acevedocrisologopablo48-lgtm/simulacion-bigbag-sesuveca/README.md

# Estación de descarga de BigBags

SESUVECA DEL PERÚ.

BigBag de 1 t. Descarga por manga y ensacado manual de 25 o 50 kg.

- [Planos](assets/docs/Planos_estacion_bigbag.pdf)
- [Materiales](assets/docs/Lista_materiales.pdf)
- [Materiales Excel](assets/docs/Lista_materiales.xlsx)
- [Archivos de taller](assets/docs/Documentacion_estacion_bigbag.zip)
- [Modelo 3D](assets/docs/Modelo_estacion_bigbag.zip)
