acevedocrisologopablo48-lgtm/simulacion-bigbag-sesuveca/assets/docs/Lista_materiales.pdf

TÍTULO

## Lista de materiales

DIBUJÓ: Javier Acevedo | FECHA: 10/11/2026 | HOJA 1 DE 3

# Estación de descarga de BigBags

## Perfiles y barras

### Peso neto de acero: 5.259,5 kg Compra estimada: 8.146,0 kg

MATERIAL | CONSUMO | PESO NETO kg | COMPRA | ESPECIFICACIÓN | PESO COMPRA kg
Tubo Ø42,4 x 2,9 mm | 17,78 m | 50,3 | 4 barras de 6 m | Tubo comercial ISO65 OD42,4x2,9 mm | 67,8
Tubo Ø48,3 x 2,9 mm | 31,29 m | 102,4 | 6 barras de 6 m | Tubo comercial ISO65 OD48,3x2,9 mm | 116,9
Tubo Ø60,3 x 3,91 mm | 34,72 m | 191,6 | 7 barras de 6 m | ASTM A53 Gr.B SCH40; OD60,3x3,91 mm | 228,4
HEB200 | 3,60 m | 220,2 | 1 barra de 6 m | HE200B / HEB200 S355; 200x200x9x15, r18; 61,3 kg/m | 367,8
IPE200 | 4,00 m | 85,6 | 1 barra de 6 m | IPE200 ASTM A36; cierre A36 de 8 mm en planchas | 134,4
Macizo 40x60 mm | 0,120 m | 2,3 | 0,17 m en cortes / retazos | ASTM A36 | 3,2
Macizo 60x60 mm | 2,34 m | 66,1 | 1 barra de 6 m | ASTM A36 | 169,6
RHS 100x60x6.3 | 7,25 m | 97,7 | 2 barras de 6 m | S355NH / EN10210-1 | 175,0
RHS 150x75x5 | 22,49 m | 371,6 | 5 barras de 6 m | ASTM A500 Gr.B | 506,3
RHS 60x40x4 | 0,515 m | 3,0 | 0,6 m en cortes / retazos | ASTM A500 Gr.B | 3,5
Redondo Ø16 mm | 0,300 m | 0,4 | 0,36 m en cortes / retazos | ASTM A36 | 0,6
Redondo Ø20 mm | 0,695 m | 1,6 | 0,8 m en cortes / retazos | ASTM A36; eje mecanizado 20h9 y puño | 2,0
Redondo Ø40 mm | 0,285 m | 1,4 | 0,35 m en cortes / retazos | ASTM A36; mecanizar aOD36/ID22 | 3,5
SHS 100x100x5 | 35,70 m | 525,5 | 7 barras de 6 m | ASTM A500 Gr.B | 626,4
SHS 150x150x6 | 37,66 m | 1.005,1 | 4 barras de 12 m | ASTM A500 Gr.B | 1.302,2
SHS 40x40x3 | 1,73 m | 6,0 | 1 barra de 6 m | ASTM A500 Gr.B | 20,9
SHS 50x50x4 | 0,135 m | 0,8 | 0,18 m en cortes / retazos | ASTM A500 Gr.B | 1,0
SHS 60x60x4 | 76,79 m | 527,5 | 7 barras de 6 m + 4 barras de 12 m | ASTM A500 Gr.B | 633,0

Cantidades de compra con reserva mínima de corte del 10% y redondeo a formatos comerciales.

TÍTULO

# Estación de descarga de BigBags

## Planchas y otros materiales

### Peso neto de acero: 5.259,5 kg Compra estimada: 8.146,0 kg

MATERIAL | CONSUMO | PESO NETO kg | COMPRA | PESO COMPRA kg
Plancha A36 de 3 mm | 4,50 m² brutos | 100,8 | 1 plancha de 2x6 m | 282,6
Plancha A36 de 5 mm | 0,016 m² brutos | 0,6 | 0,018 m² en cortes de 5 mm | 0,7
Plancha A36 de 6 mm | 5,61 m² brutos | 239,7 | 2 planchas de 1,5x3 m | 423,9
Plancha A36 de 8 mm | 11,10 m² brutos | 445,9 | 5 planchas de 1,5x3 m | 1.413,0
Plancha A36 de 10 mm | 0,385 m² brutos | 27,9 | 0,424 m² en cortes de 10 mm | 33,3
Plancha A36 de 12 mm | 2,54 m² brutos | 214,3 | 1 plancha de 1,5x3 m | 423,9
Plancha A36 de 18 mm | 1,94 m² brutos | 205,2 | 2,133 m² en cortes de 18 mm | 301,4
Plancha A36 de 20 mm | 0,707 m² brutos | 107,9 | 0,778 m² en cortes de 20 mm | 122,1
Plancha A36 de 25 mm | 0,125 m² brutos | 24,1 | 0,138 m² en cortes de 25 mm | 27,1
Plancha A36 de 30 mm | 0,045 m² brutos | 10,6 | 0,05 m² en cortes de 30 mm | 11,8
Plancha A36 de 35 mm | 1,23 m² brutos | 293,0 | 1,359 m² en cortes de 35 mm | 373,4
Plancha A36 de 40 mm | 0,047 m² brutos | 9,4 | 0,052 m² en cortes de 40 mm | 16,3
Plancha A36 de 45 mm | 0,461 m² brutos | 162,4 | 0,507 m² en cortes de 45 mm | 179,1
Conjuntos de acero formado | 158,45 kg | 158,5 | 175 kg para fabricar según planos | 175,0
Peldaños 800x250 mm | 15,00 ud | - | 15 peldaños completos | -
Rejilla de piso y transición | 4,90 m² | - | 5,39 m² cortados | -
UHMWPE de 10 mm | 12,55 m² brutos | - | 13,804 m² en cortes | -
Goma de abrazadera | 1,00 juego | - | 1 juego de revestimiento | -

Planchas ASTM A36. Rejilla portante de 32 x 5 mm y PE-UHMW1000 de 10 mm. Conjuntos formados según planos.

Cantidades de compra con reserva mínima de corte del 10% y redondeo a formatos comerciales.

TÍTULO

# Estación de descarga de BigBags

## Equipos y suministros

Cantidades por estación. BigBag de trabajo de 1 t; sacos de 25 y 50 kg.

EQUIPO | CANTIDAD | ESPECIFICACIÓN TÉCNICA
Tecle y carro eléctricos | 1 conjunto | KITO SHER2M020IS-IS, capacidad 2 t; altura reducida 475 mm; masa 212 kg. Suministro 380 V, trifásico, 60 Hz. Cadena útil mínima 4 m; carro para ala de 200 x 15 mm y traslado limitado a 10 m/min. Potencia de referencia a 50 Hz: izaje 3,5 kW y carro 0,4 kW. Incluye ruedas, cadena, gancho, frenos y finales de carrera. BigBag de trabajo 1.000 kg más aparejo de 260 kg.
Balanza fija | 1 kit | Capacidad útil 150 kg; tara admisible mínima 120 kg; lectura 0,05 kg. Cuatro celdas Dini Argeo FXC200-1, C3, 200 kg/celda, 2 mV/V, IP68; indicador DFWL, caja sumadora de 4 vías, cables y montajes. Plato 900 x 1.000 mm a 350 mm del piso; masa móvil 97,13 kg. Calibración y ajuste de esquinas al montaje.
Mando y conexión del tecle | 1 juego | Mando mantenido de 4 movimientos, parada enclavable y rearme, a 1,25 m del piso. Cableado, festón y protecciones compatibles con el tecle. Incluir en el suministro del conjunto.
Filtro de venteo | 1 unidad | Conexión DN150 y cartucho antiestático para polvo de carbón; montaje y sellos incluidos. Venteo por desplazamiento de aire, sin ventilador.
Sello flexible de recepción | 1 juego | Receptor de entrada libre Ø450 mm; manga de BigBag Ø350 mm. Sello de doble labio, Ø450 x 55 mm, en elastómero disipativo compatible con carbón y limpieza.
Apoyos y retención de paleta | 1 kit | Dos bujes igus GSM-2022-20, Ø20/22 x 20 mm, y dos collares partidos Ruland MSP-20-F, Ø20/40 x 15 mm. Eje 20h9, alojamientos 22H7 y juego axial total 0,2-0,5 mm. Paleta Ø249 x 6 mm y cuello DN250 incluidos en el acero de fabricación.
Fijaciones de montaje | 1 lote | 52 espárragos M16 x 340, clase 10.9; 104 tuercas M16, clase 10. Ocho pernos M16 F3125/A325M para las sillas, con tuercas y arandelas compatibles. Tornillería M8 de tapas y abrazadera según plano. Las 104 arandelas A36 de 50 x 50 x 10 mm, Ø18, están incluidas en la plancha de 10 mm.

Pesos del acero. Equipos, fijaciones compradas, rejillas y polímeros se suministran por separado.
