acevedocrisologopablo48-lgtm/simulacion-bigbag-sesuveca/assets/docs/ESTACION_BIGBAG_P05.step

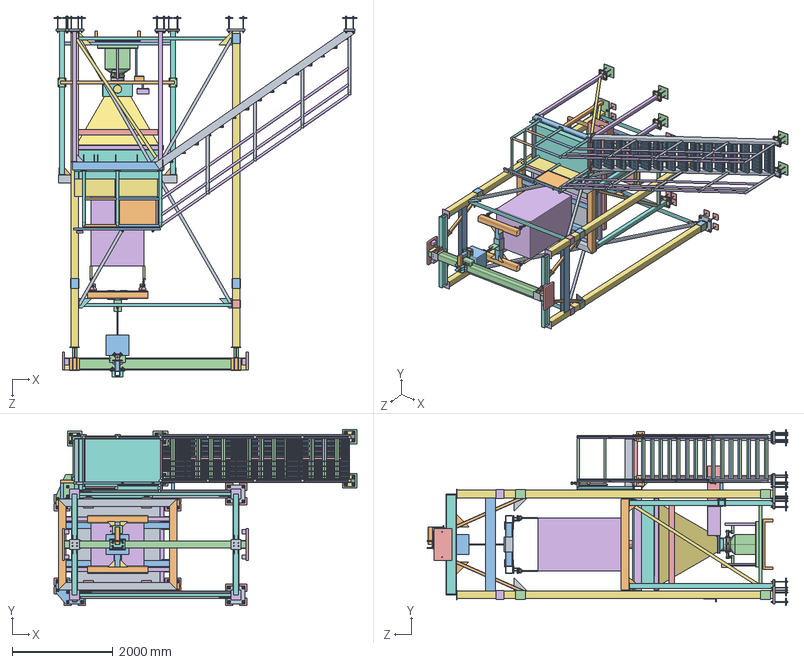
[picture p1: CAD file, 2026-10-23, last stored version]
assets/docs/ESTACION_BIGBAG_P05.step
6005.0 x 3497.5 x 7155.0 mm
BASE_PORTICO_360x360x35 x 2
BASE_TOLVA_250x250x25 x 2
BASE_COMBINADA_PORTICO_TOLVA_SUR_t35_P05
BASE_COMBINADA_PORTICO_TOLVA_NORTE_t35_P05
PASANTE_M16_8p8_L340_P05 x 52
ANCLA_ARANDELA_D30_D18_t3_REF x 28
ANCLA_TUERCA_M16_AF24_H13_REF x 28
CALCE_PASANTE_BASE_TOLVA_250x250x25_t10 x 2
CALCE_PASANTE_AC_BASE_220x220x12_t35 x 5
PASANTE_ARANDELA_A36_50x50x10_D18_P05 x 104
PASANTE_TUERCA_BRIDA_M16_CL10_D34p5_H16_REF x 104
CONTRAPLACA_COMUN_A36_290x290x18_G01_P05
CONTRAPLACA_COMUN_A36_290x290x18_G02_P05
CONTRAPLACA_COMUN_A36_290x290x18_G03_P05
CONTRAPLACA_COMUN_A36_290x290x18_G04_P05
CONTRAPLACA_COMUN_A36_290x290x18_G05_P05
CONTRAPLACA_A36_150x150x18_D18_P05 x 26
CONTRAPLACA_COMUN_A36_175x360x18_G25_P05
CONTRAPLACA_COMUN_A36_175x360x18_G30_P05
SHS150x150x6_L5488000_P05 x 4
IPE200_L2000000_P05 x 2
U01_CAP_200x200x12_P05 x 2
U01_LATERAL_200x240x12_P05 x 4
U01_CALCE_200x20x6_P05 x 8
U01_RIGIDIZADOR_44x175x6_P05 x 24
U01_CARTELA_100x240x12_P05 x 8
P01_CAP_COLUMNA_200x200x12_P05 x 4
CUNA_BOTONERA_A36_t3
SHS60x60x4_L3050000_P05_JUNTA_14
SHS60x60x4_L3050000_P05_JUNTA_15
SHS60x60x4_L6085645_SLOT_P05_JUNTA_1
SHS60x60x4_L6085645_SLOT_P05_JUNTA_2
SHS60x60x4_L748810_SLOT_P05_JUNTA_3 x 2
SHS60x60x4_L3050000_P05_JUNTA_16
SHS60x60x4_L3050000_P05_JUNTA_17
SHS60x60x4_L6085645_SLOT_P05_JUNTA_4
SHS60x60x4_L6085645_SLOT_P05_JUNTA_5
SHS60x60x4_L748810_SLOT_P05_JUNTA_6 x 2
U02_COLLAR_150x200x12_P05 x 12
U02_COLLAR_174x200x12_P05 x 12
U02_COLLAR_150x158x12_P05 x 4
U02_COLLAR_174x158x12_P05 x 4
U02_CARTELA_BRL-A--1_0_P05
U02_CARTELA_BRL-A--1_1_P05
U02_CARTELA_BRL-B--1_0_P05
U02_CARTELA_BRL-B--1_1_P05
U02_CARTELA_KNE--1_0_P05 x 2
U02_CARTELA_KNE--1_1_P05 x 2
U02_CARTELA_BRL-A-1_0_P05
U02_CARTELA_BRL-A-1_1_P05
U02_CARTELA_BRL-B-1_0_P05
U02_CARTELA_BRL-B-1_1_P05
U02_CARTELA_KNE-1_0_P05 x 2
U02_CARTELA_KNE-1_1_P05 x 2
PORTICO_CIERRE_IPE200_2000x200x8_P05 x 4
I_A240x140x8x20_L3600000_P05
TOPE_PLACA_REACCION_640x360x45_P05 x 2
TOPE_ACE_TR100_60_ENVOLVENTE_PRESELECCION_REF x 4
TOPE_RIGIDIZADOR_TERMINAL_100x240x12_P05 x 4
SHS100x100x5_L2848000_P05 x 4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
