acevedocrisologopablo48-lgtm/simulacion-bigbag-sesuveca/assets/docs/Planos_estacion_bigbag.pdf

F | F

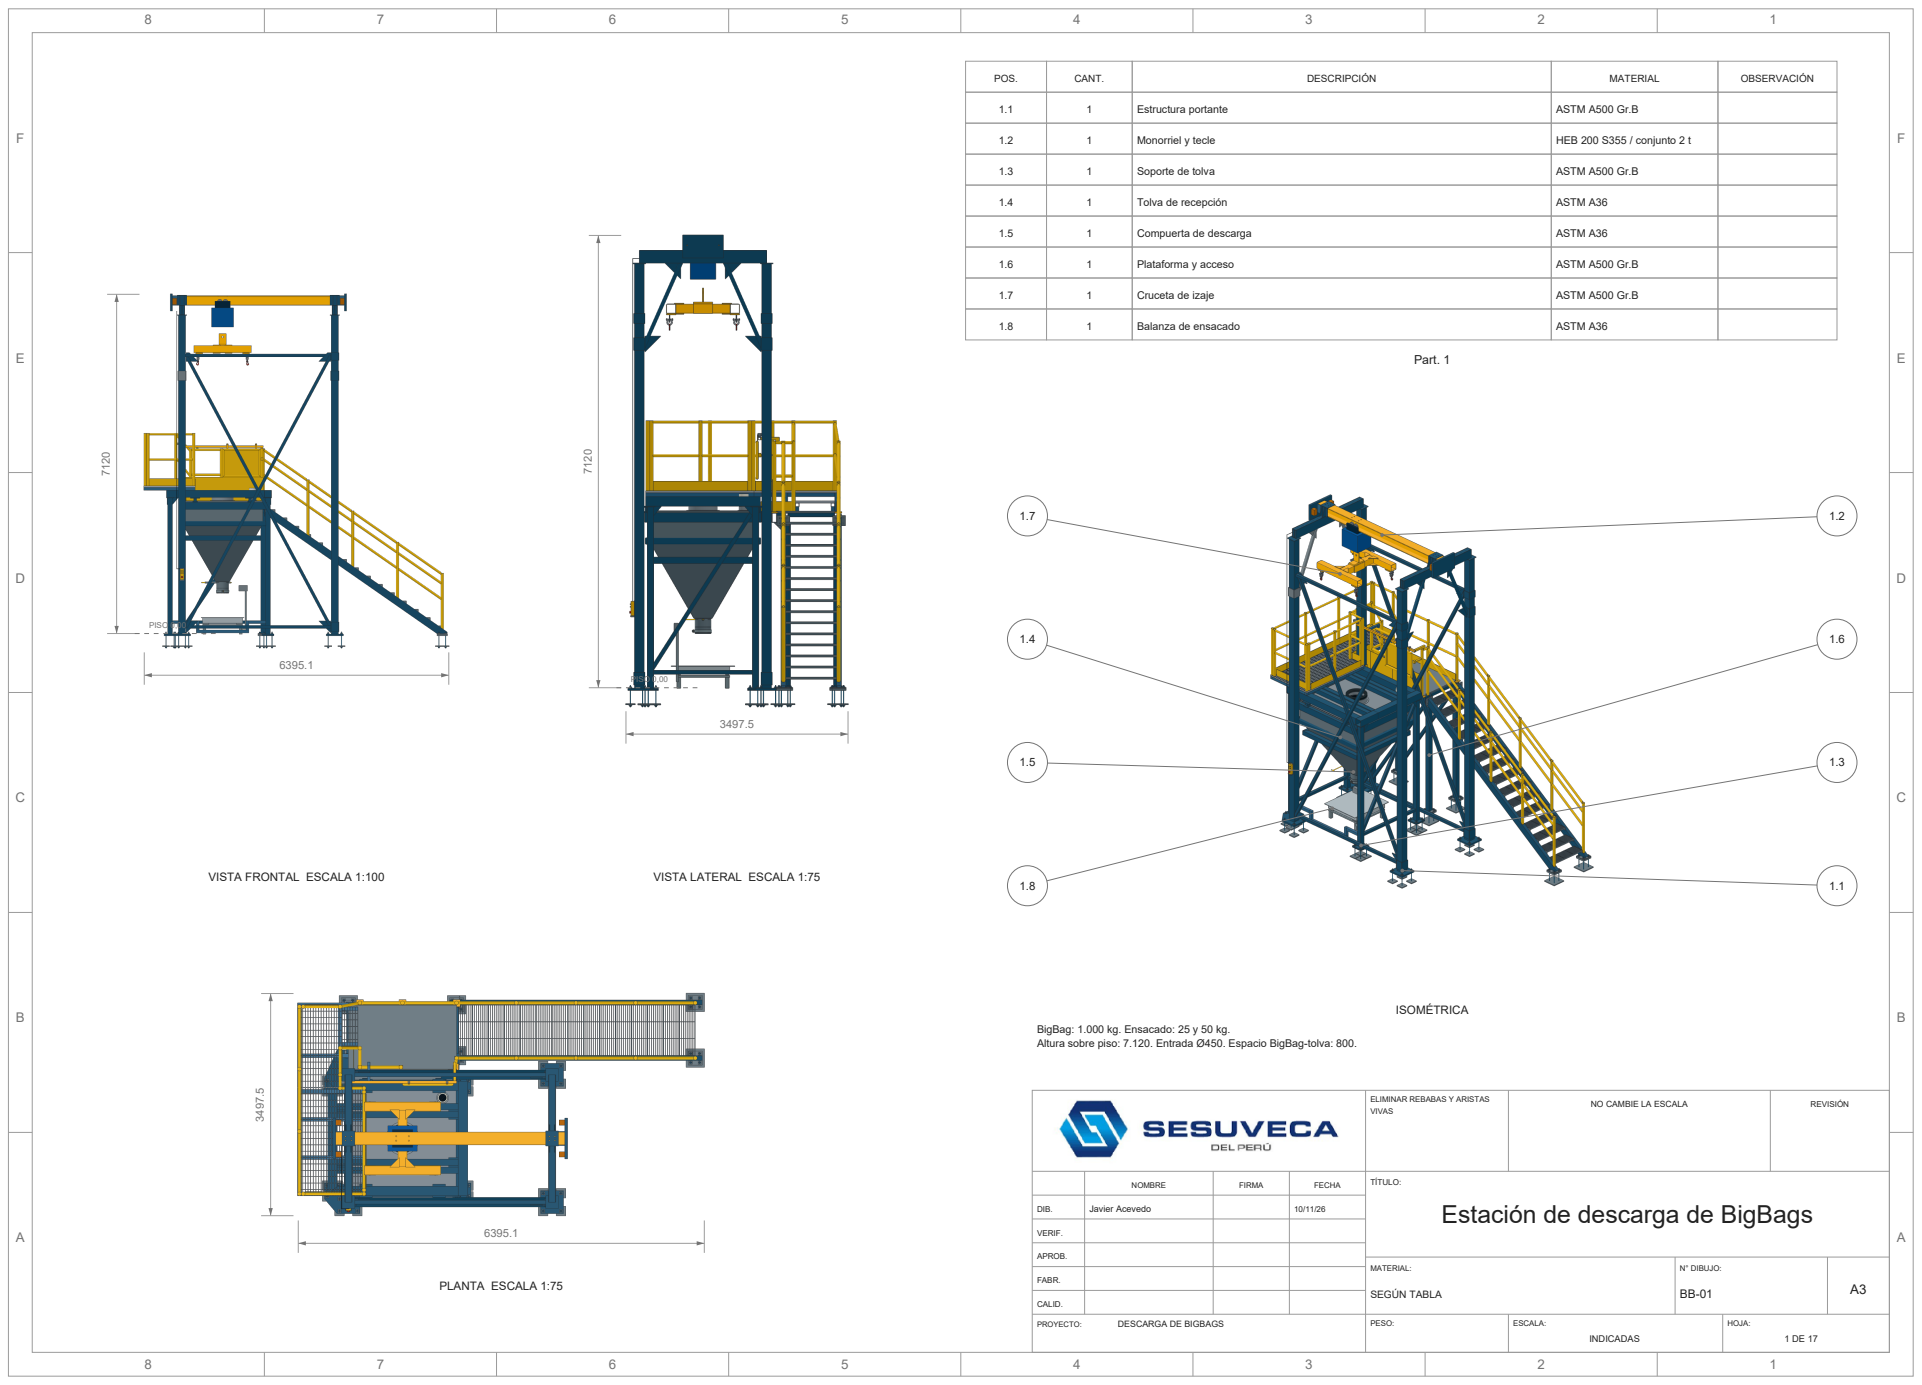
[picture p2: page 1]
NO CAMBIE LA ESCALA; REVISIÓN; NOMBRE; FIRMA; FECHA; DIB.; VERIF.; APROB.; FABR.; CALID.; Javier Acevedo; PROYECTO:; DESCARGA DE BIGBAGS; TÍTULO:; MATERIAL:; SEGÚN TABLA; N° DIBUJO:; PESO:; ESCALA:; INDICADAS; HOJA:; POS.; CANT.; DESCRIPCIÓN; MATERIAL; OBSERVACIÓN; Estructura portante; ASTM A500 Gr.B; Monorriel y tecle; HEB 200 S355 / conjunto 2 t; Soporte de tolva; Tolva de recepción; ASTM A36; Compuerta de descarga; Plataforma y acceso; Cruceta de izaje; Balanza de ensacado; PISO 0,00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

VISTA FRONTAL ESCALA 1:100

VISTA LATERAL ESCALA 1:75

BigBag: 1.000 kg. Ensacado: 25 y 50 kg.
Altura sobre piso: 7.120. Entrada Ø450. Espacio BigBag-tolva: 800.

ELIMINAR REBABAS Y ARISTAS
VIVAS

Estación de descarga de BigBags

F | F

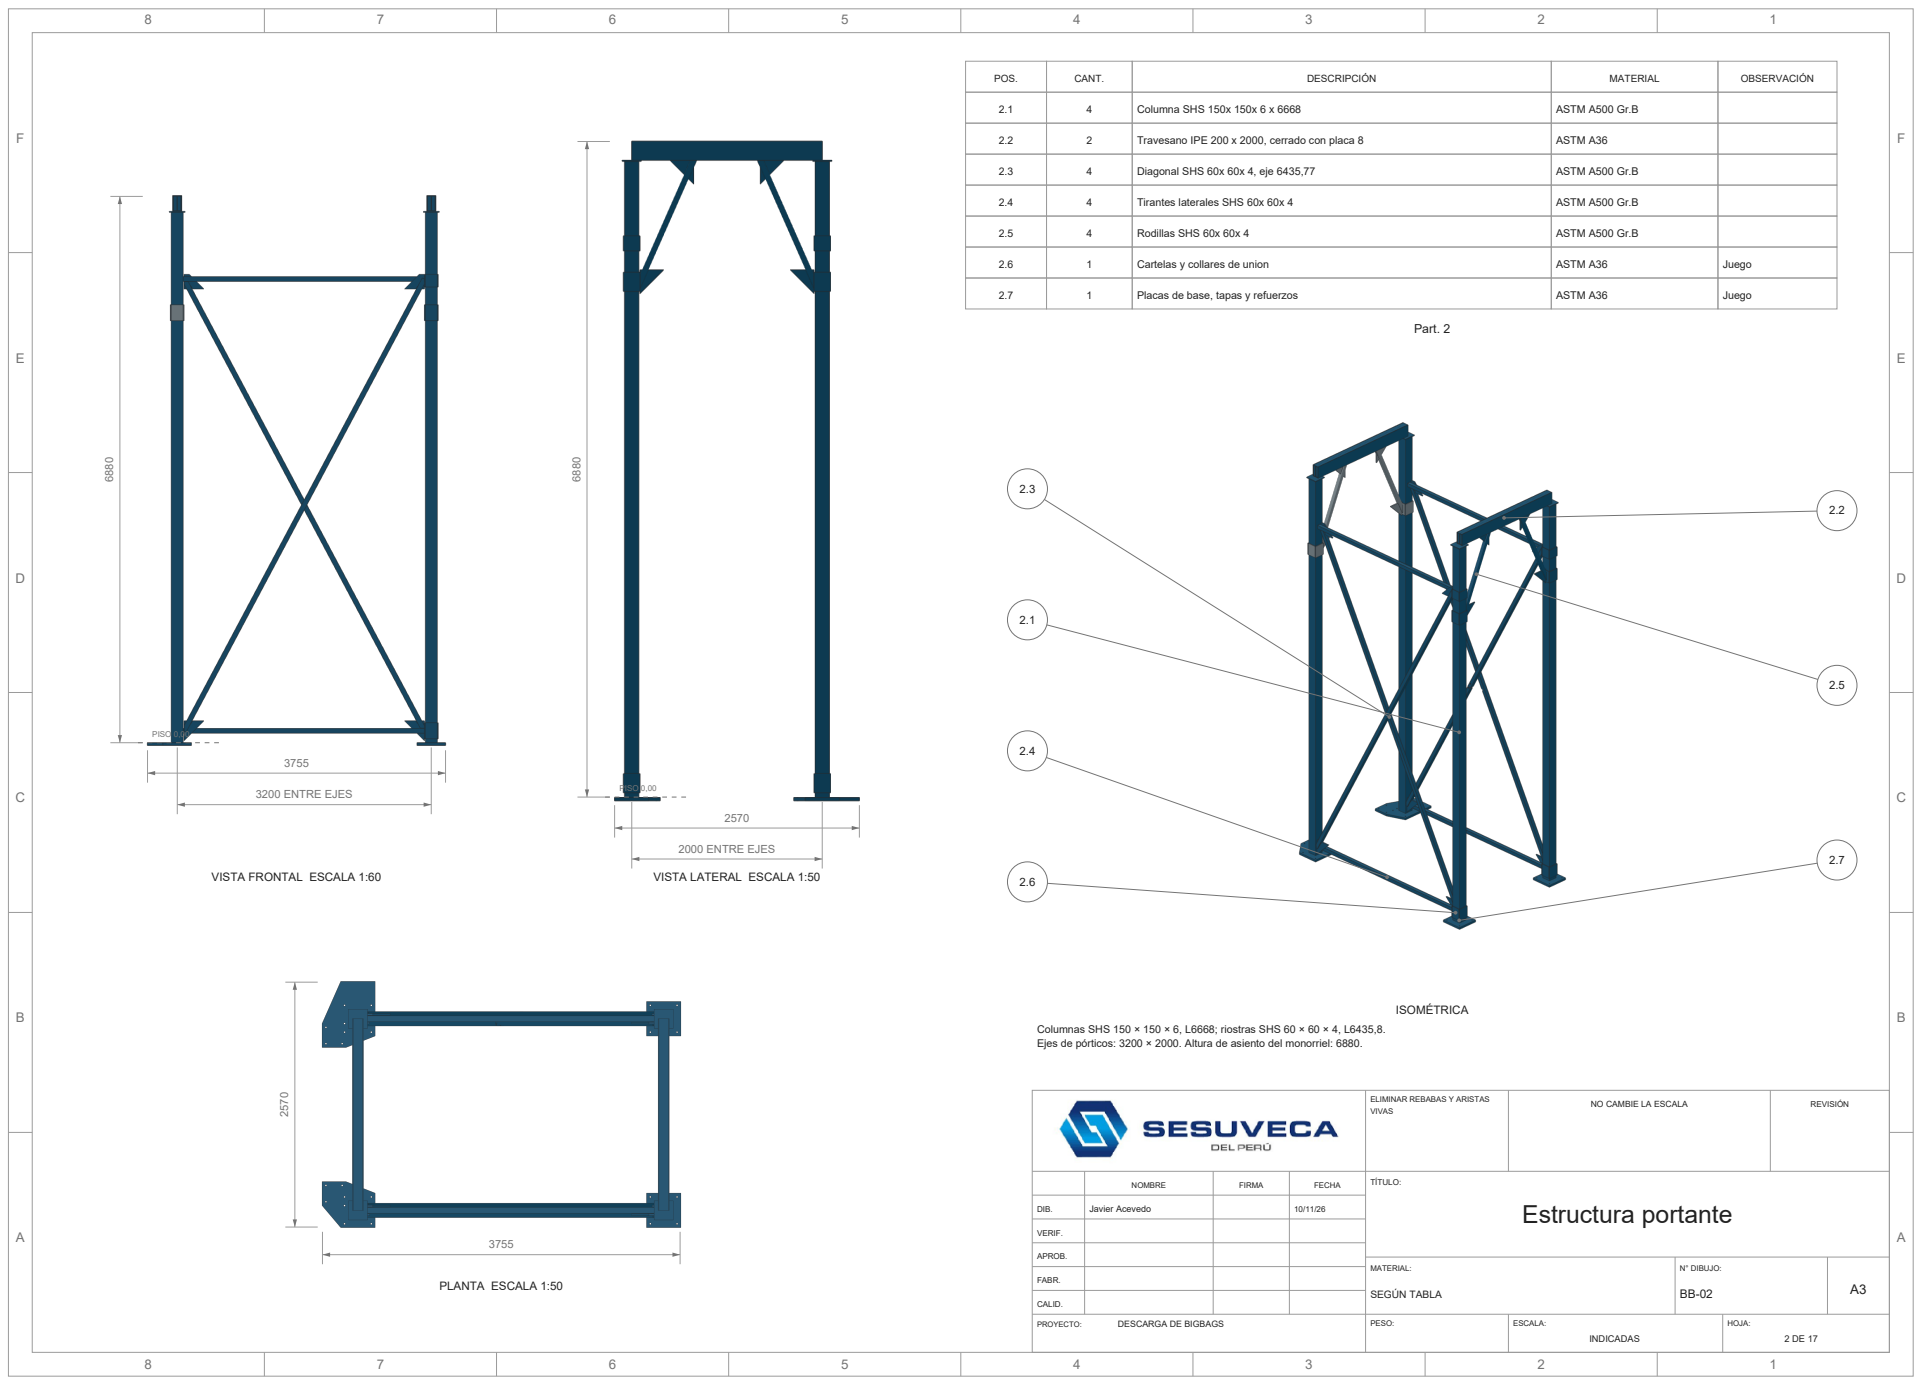
[picture p3: page 2]
NO CAMBIE LA ESCALA; REVISIÓN; NOMBRE; FIRMA; FECHA; DIB.; VERIF.; APROB.; Javier Acevedo; TÍTULO:; Estructura portante; MATERIAL:; N° DIBUJO:; Columna SHS 150x 150x 6 x 6668; ASTM A500 Gr.B; Travesano IPE 200 x 2000, cerrado con placa 8; ASTM A36; Diagonal SHS 60x 60x 4, eje 6435,77; Tirantes laterales SHS 60x 60x 4; Rodillas SHS 60x 60x 4; Cartelas y collares de union; Juego; Placas de base, tapas y refuerzos; PISO 0,00; ISOMÉTRICA; Part. 2; 3200 ENTRE EJES; 2000 ENTRE EJES

VISTA FRONTAL ESCALA 1:60

VISTA LATERAL ESCALA 1:50

Columnas SHS 150 × 150 × 6, L6668; riostras SHS 60 × 60 × 4, L6435,8.
Ejes de pórticos: 3200 × 2000. Altura de asiento del monorriel: 6880.

ELIMINAR REBABAS Y ARISTAS
VIVAS

F | F

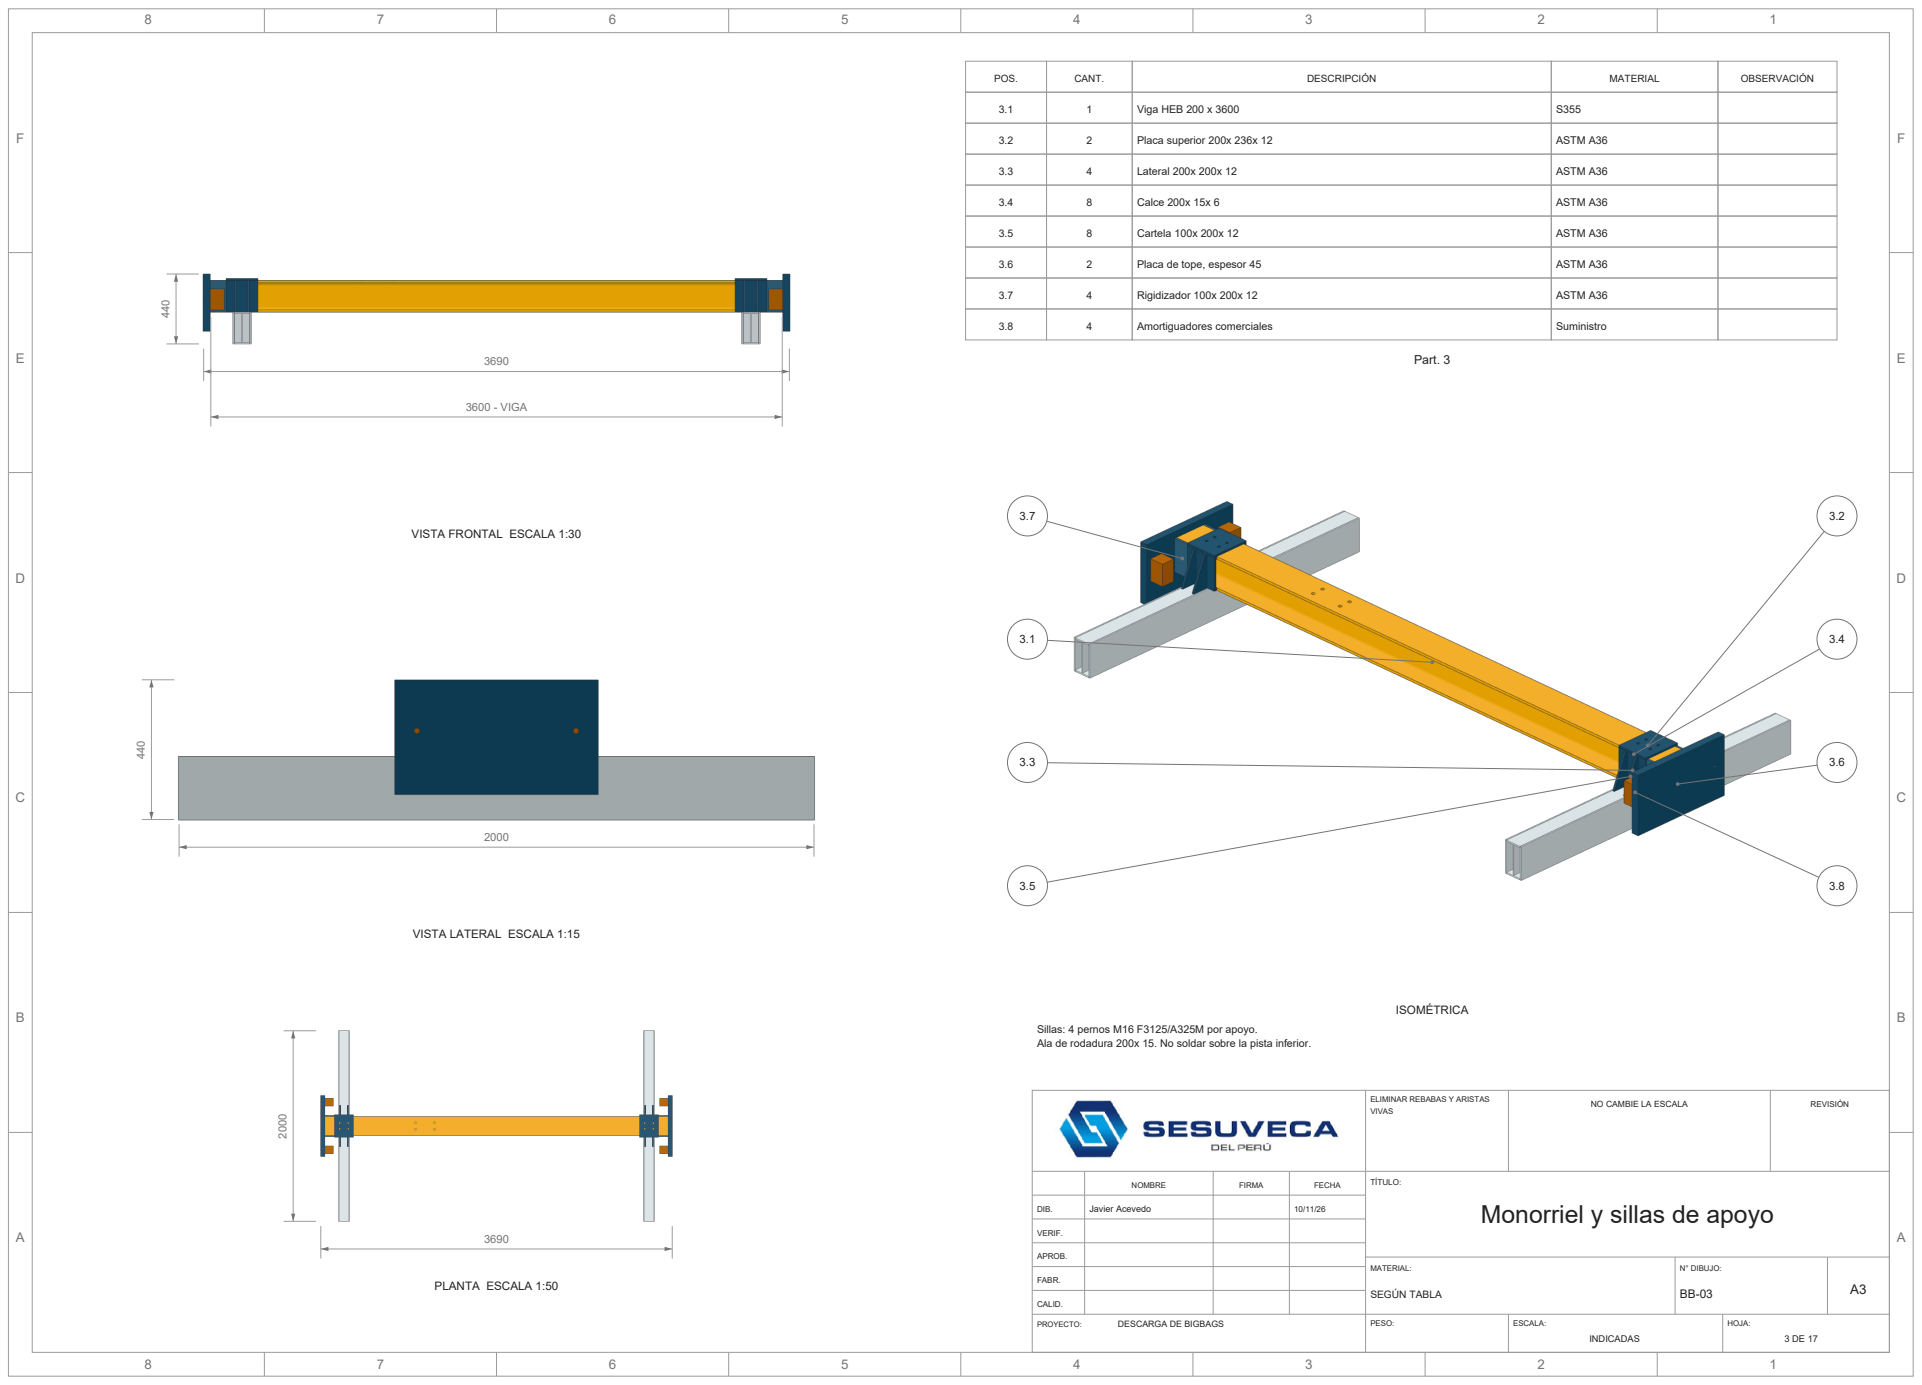
[picture p4: page 3]
NO CAMBIE LA ESCALA; REVISIÓN; NOMBRE; FIRMA; FECHA; DIB.; VERIF.; APROB.; Javier Acevedo; TÍTULO:; MATERIAL:; N° DIBUJO:; Viga HEB 200 x 3600; Placa superior 200x 236x 12; ASTM A36; Lateral 200x 200x 12; Calce 200x 15x 6; Cartela 100x 200x 12; Placa de tope, espesor 45; Rigidizador 100x 200x 12; Amortiguadores comerciales; Suministro; ISOMÉTRICA; Part. 3; 3600 - VIGA

VISTA FRONTAL ESCALA 1:30

VISTA LATERAL ESCALA 1:15

Sillas: 4 pernos M16 F3125/A325M por apoyo.
Ala de rodadura 200x 15. No soldar sobre la pista inferior.

ELIMINAR REBABAS Y ARISTAS
VIVAS

Monorriel y sillas de apoyo

F | F

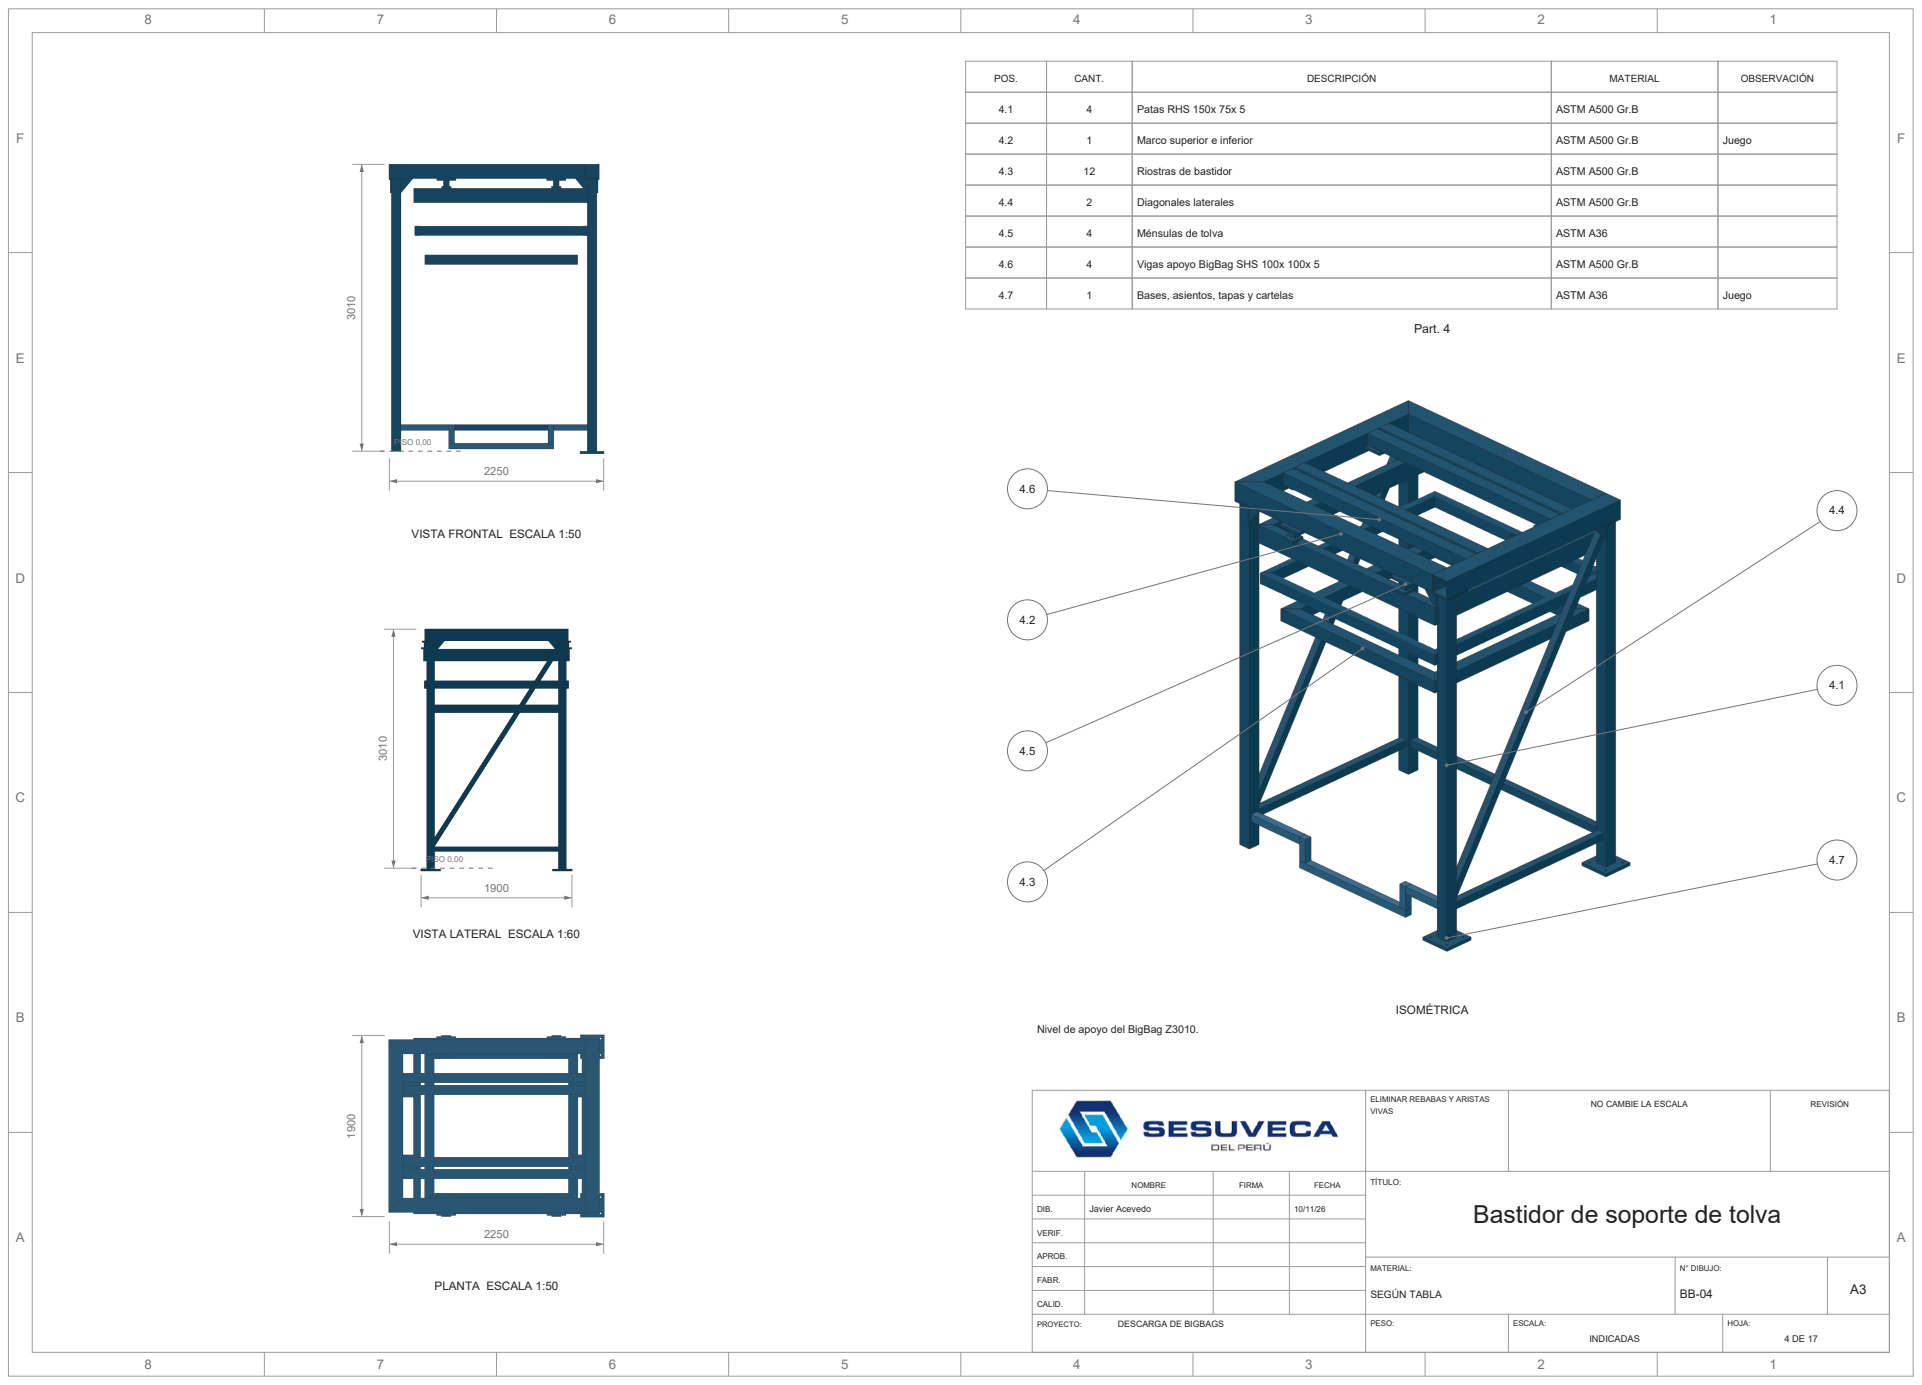
[picture p5: page 4]
NO CAMBIE LA ESCALA; REVISIÓN; NOMBRE; FIRMA; FECHA; DIB.; VERIF.; APROB.; Javier Acevedo; TÍTULO:; MATERIAL:; N° DIBUJO:; Patas RHS 150x 75x 5; ASTM A500 Gr.B; Marco superior e inferior; Juego; Riostras de bastidor; Diagonales laterales; Ménsulas de tolva; ASTM A36; Vigas apoyo BigBag SHS 100x 100x 5; Bases, asientos, tapas y cartelas; PISO 0,00; ISOMÉTRICA; Part. 4

VISTA FRONTAL ESCALA 1:50

VISTA LATERAL ESCALA 1:60

Nivel de apoyo del BigBag Z3010.

ELIMINAR REBABAS Y ARISTAS
VIVAS

Bastidor de soporte de tolva

F | F

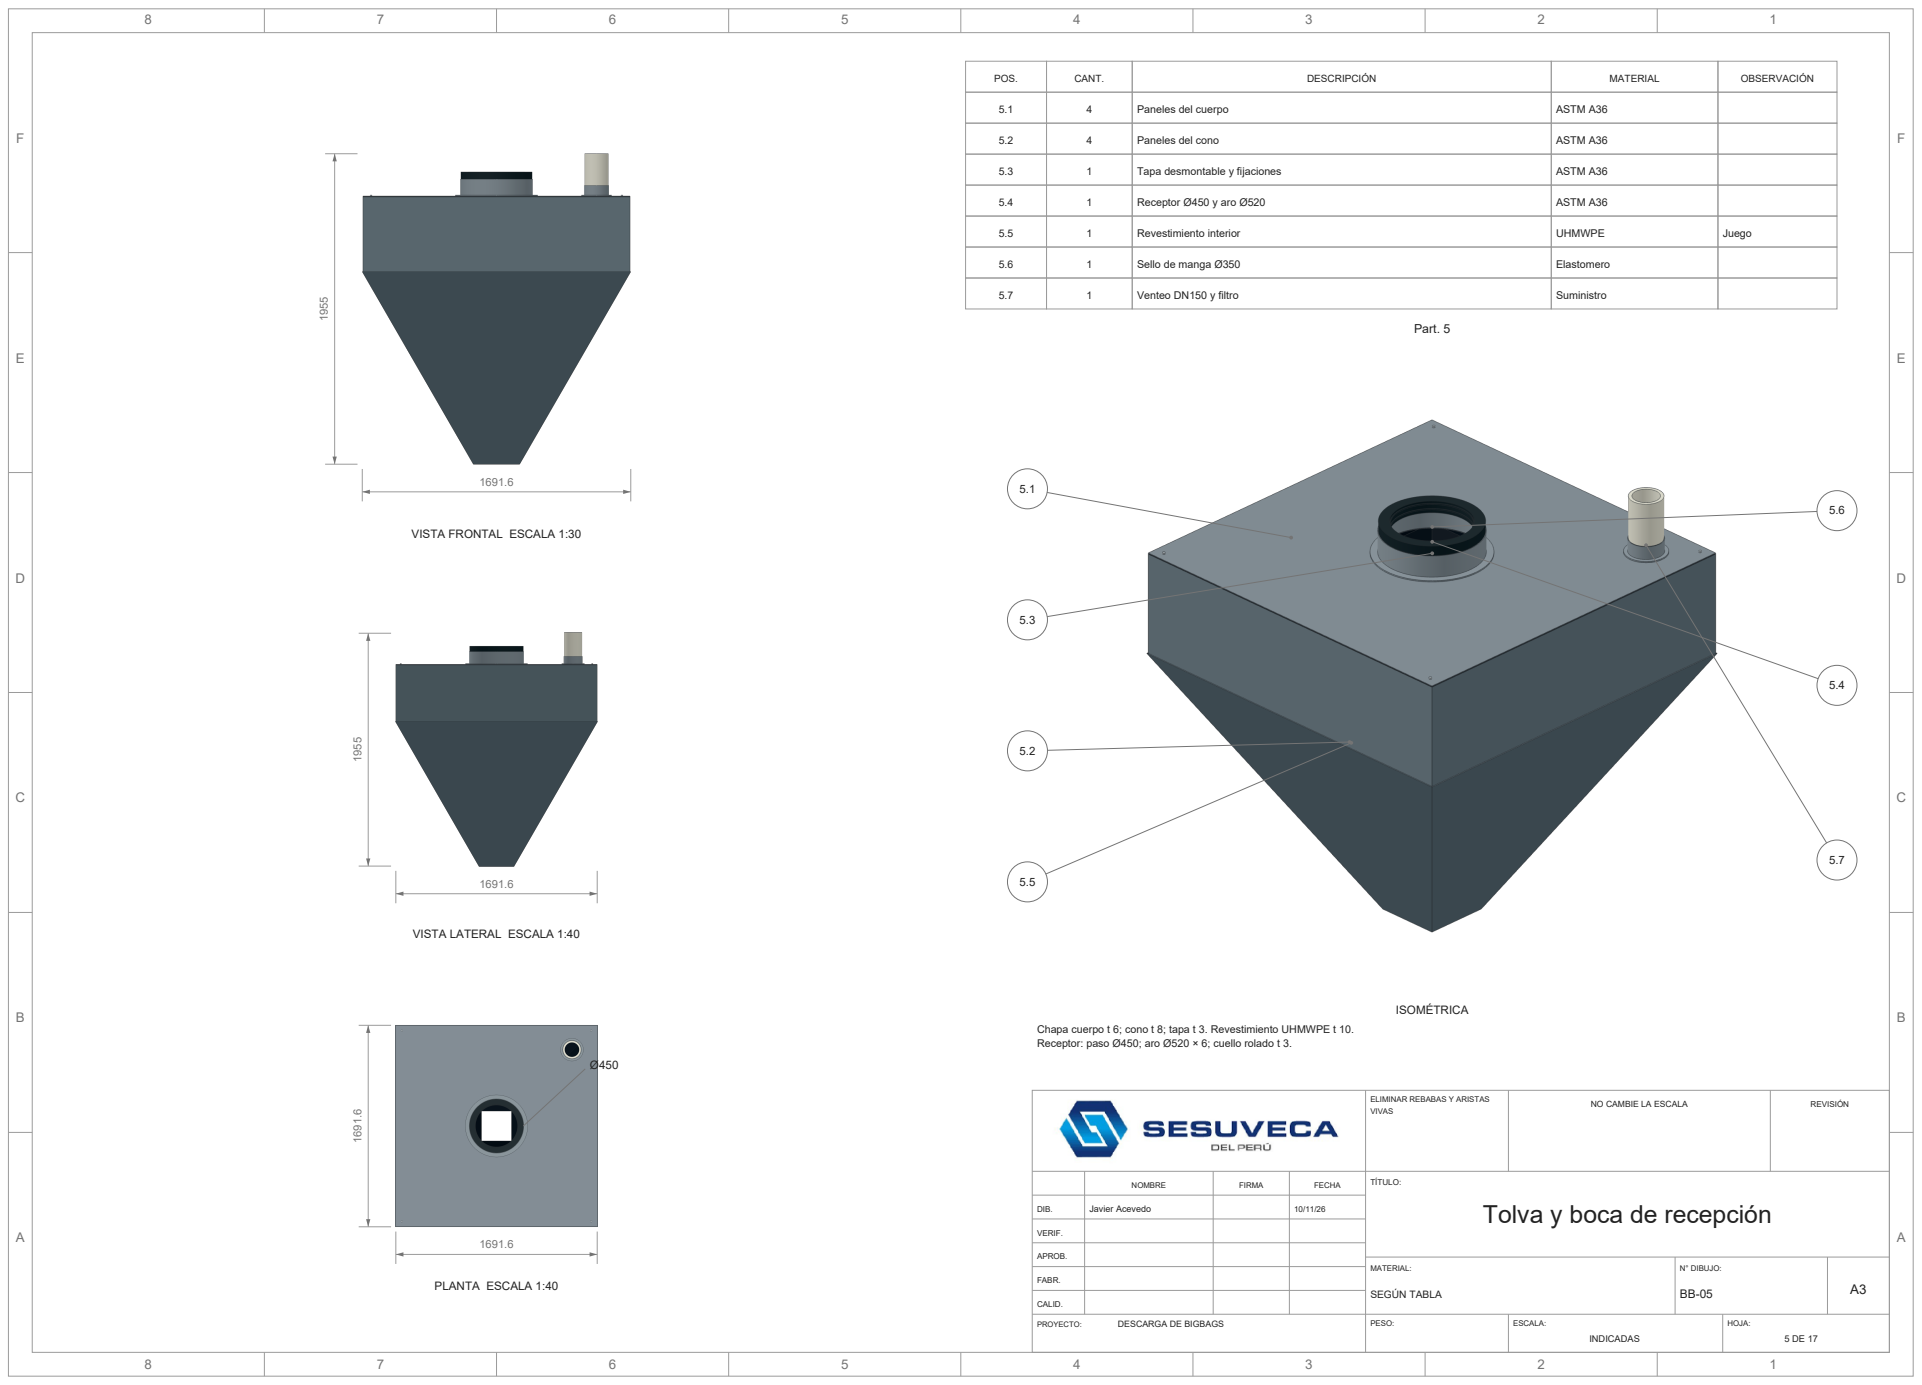
[picture p6: page 5]
NO CAMBIE LA ESCALA; REVISIÓN; NOMBRE; FIRMA; FECHA; DIB.; VERIF.; APROB.; Javier Acevedo; TÍTULO:; MATERIAL:; N° DIBUJO:; Paneles del cuerpo; ASTM A36; Paneles del cono; Tapa desmontable y fijaciones; Receptor Ø450 y aro Ø520; Revestimiento interior; UHMWPE; Juego; Sello de manga Ø350; Elastomero; Venteo DN150 y filtro; Suministro; ISOMÉTRICA; Part. 5

VISTA FRONTAL ESCALA 1:30

VISTA LATERAL ESCALA 1:40

Chapa cuerpo t 6; cono t 8; tapa t 3. Revestimiento UHMWPE t 10.
Receptor: paso Ø450; aro Ø520 × 6; cuello rolado t 3.

ELIMINAR REBABAS Y ARISTAS
VIVAS

Tolva y boca de recepción

F | F

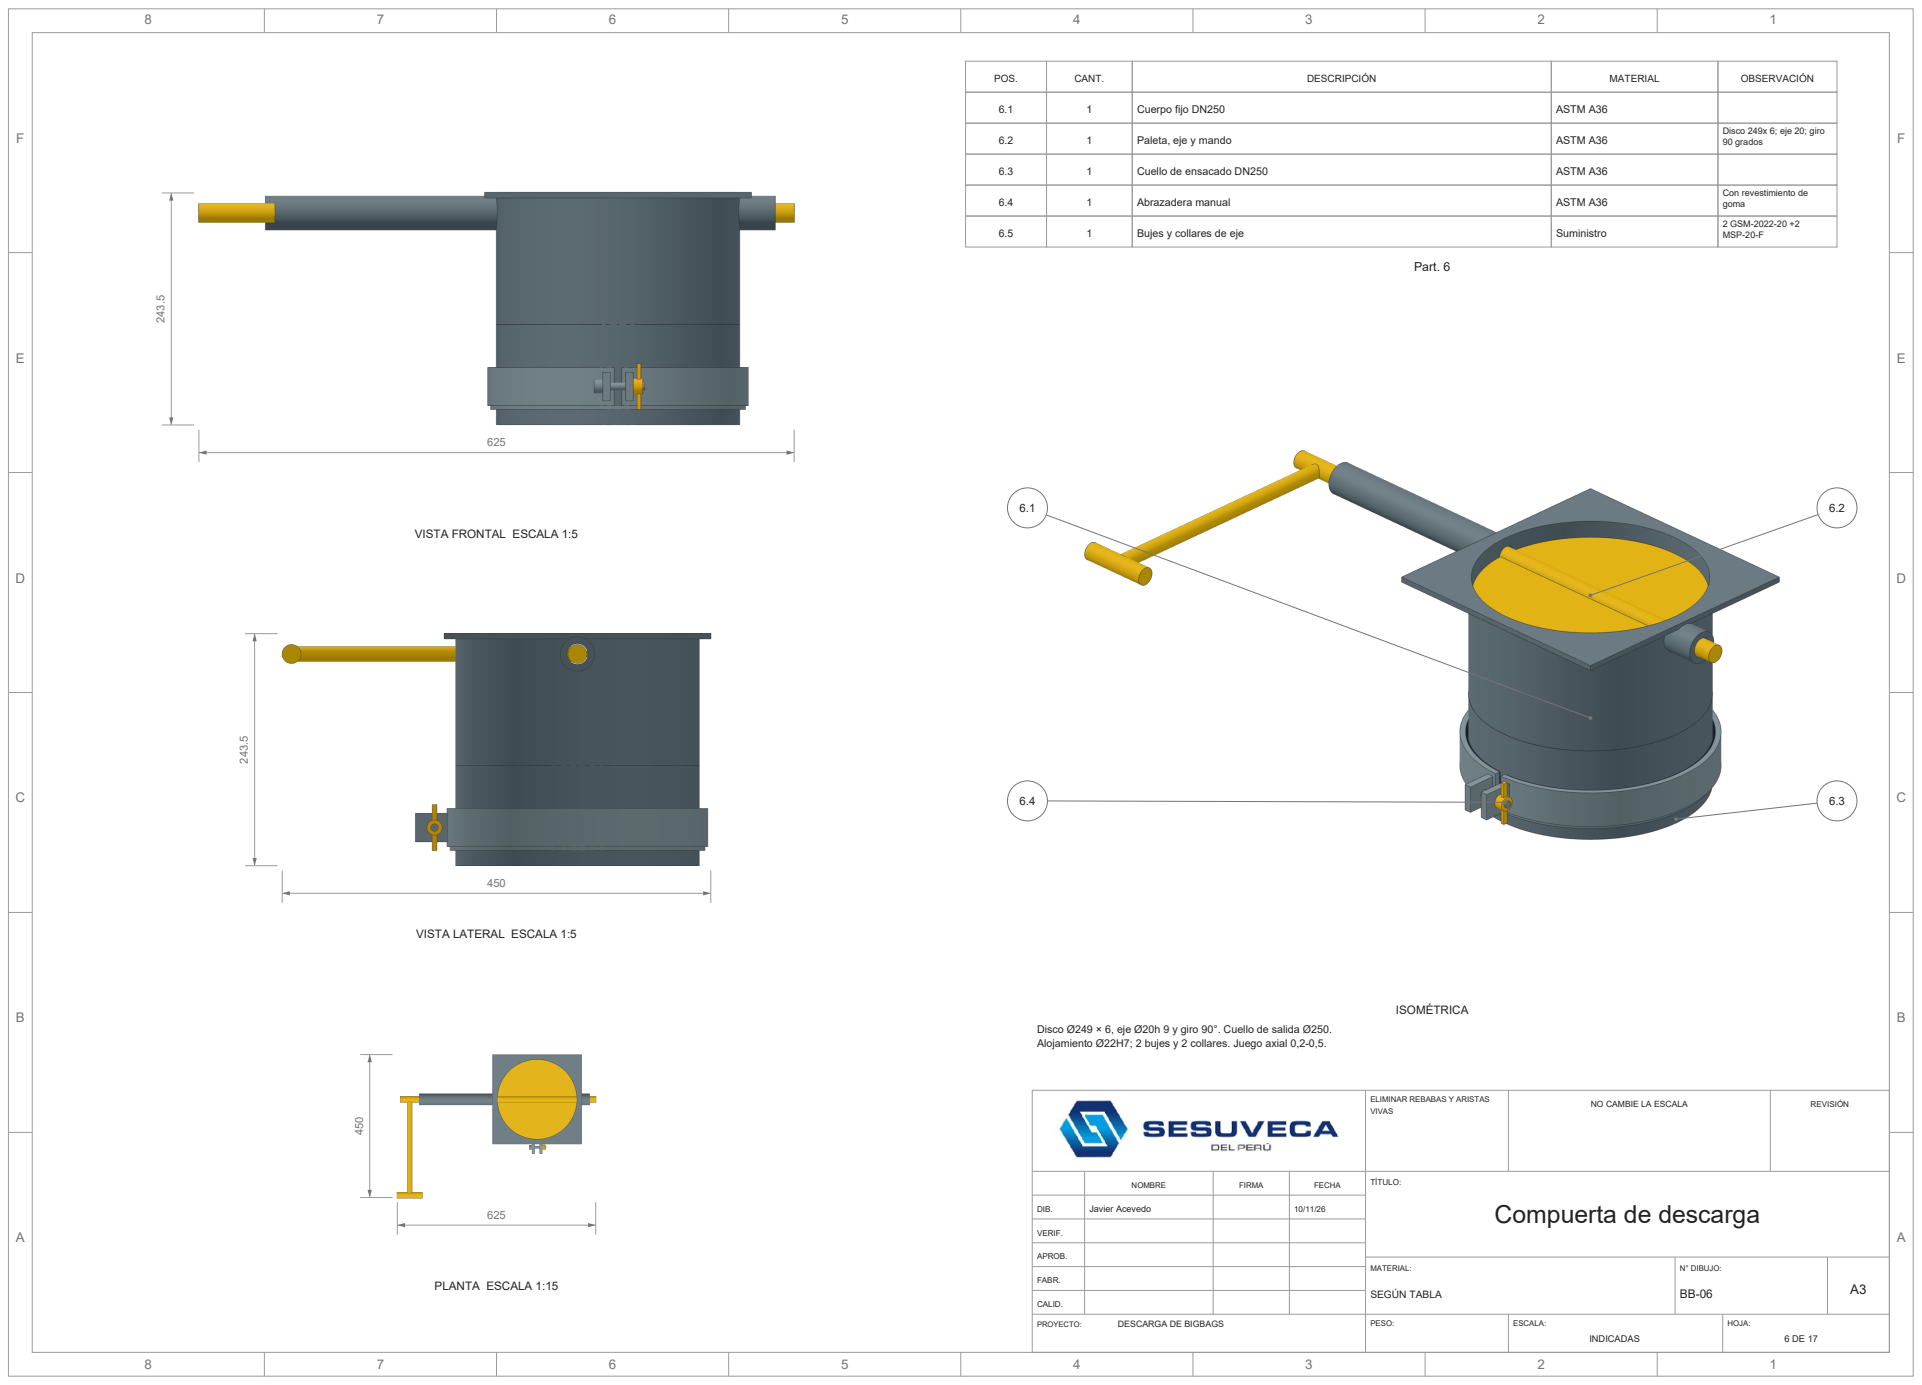
[picture p7: page 6]
NO CAMBIE LA ESCALA; REVISIÓN; NOMBRE; FIRMA; FECHA; DIB.; VERIF.; APROB.; Javier Acevedo; TÍTULO:; MATERIAL:; N° DIBUJO:; Cuerpo fijo DN250; ASTM A36; Paleta, eje y mando; Cuello de ensacado DN250; Abrazadera manual; Bujes y collares de eje; Suministro; 2 GSM-2022-20 +2 MSP-20-F; ISOMÉTRICA; Part. 6

Disco 249x 6; eje 20; giro
90 grados

Con revestimiento de
goma

VISTA FRONTAL ESCALA 1:5

VISTA LATERAL ESCALA 1:5

Disco Ø249 × 6, eje Ø20h 9 y giro 90°. Cuello de salida Ø250.
Alojamiento Ø22H7; 2 bujes y 2 collares. Juego axial 0,2-0,5.

ELIMINAR REBABAS Y ARISTAS
VIVAS

Compuerta de descarga

F | F

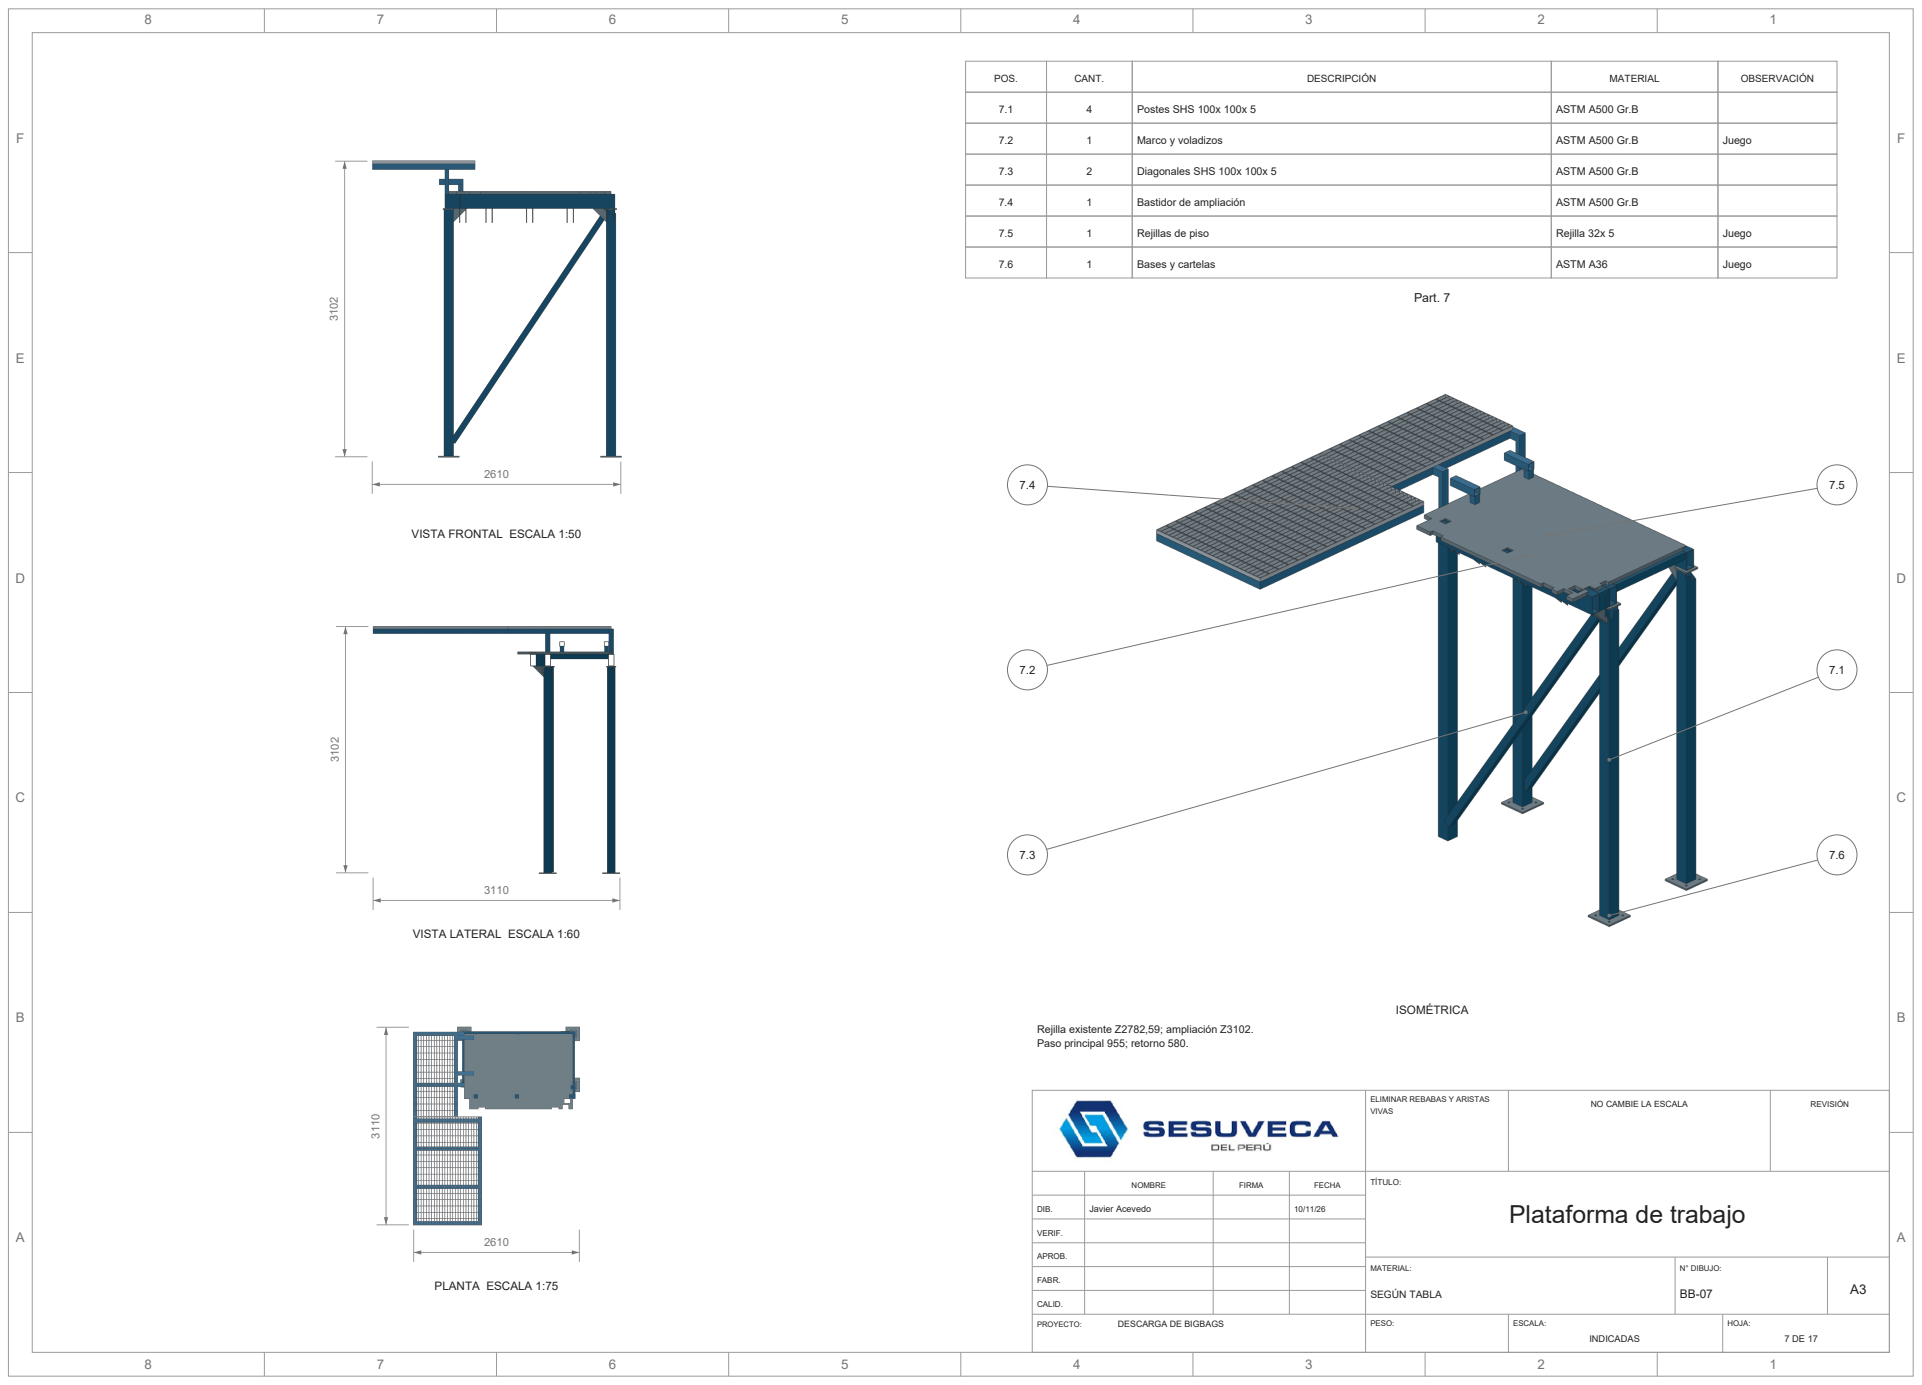
[picture p8: page 7]
NO CAMBIE LA ESCALA; REVISIÓN; NOMBRE; FIRMA; FECHA; DIB.; VERIF.; APROB.; Javier Acevedo; TÍTULO:; MATERIAL:; N° DIBUJO:; Postes SHS 100x 100x 5; ASTM A500 Gr.B; Marco y voladizos; Juego; Diagonales SHS 100x 100x 5; Bastidor de ampliación; Rejillas de piso; Rejilla 32x 5; Bases y cartelas; ASTM A36; ISOMÉTRICA; Part. 7

VISTA FRONTAL ESCALA 1:50

VISTA LATERAL ESCALA 1:60

Rejilla existente Z2782,59; ampliación Z3102.
Paso principal 955; retorno 580.

ELIMINAR REBABAS Y ARISTAS
VIVAS

Plataforma de trabajo

F | F

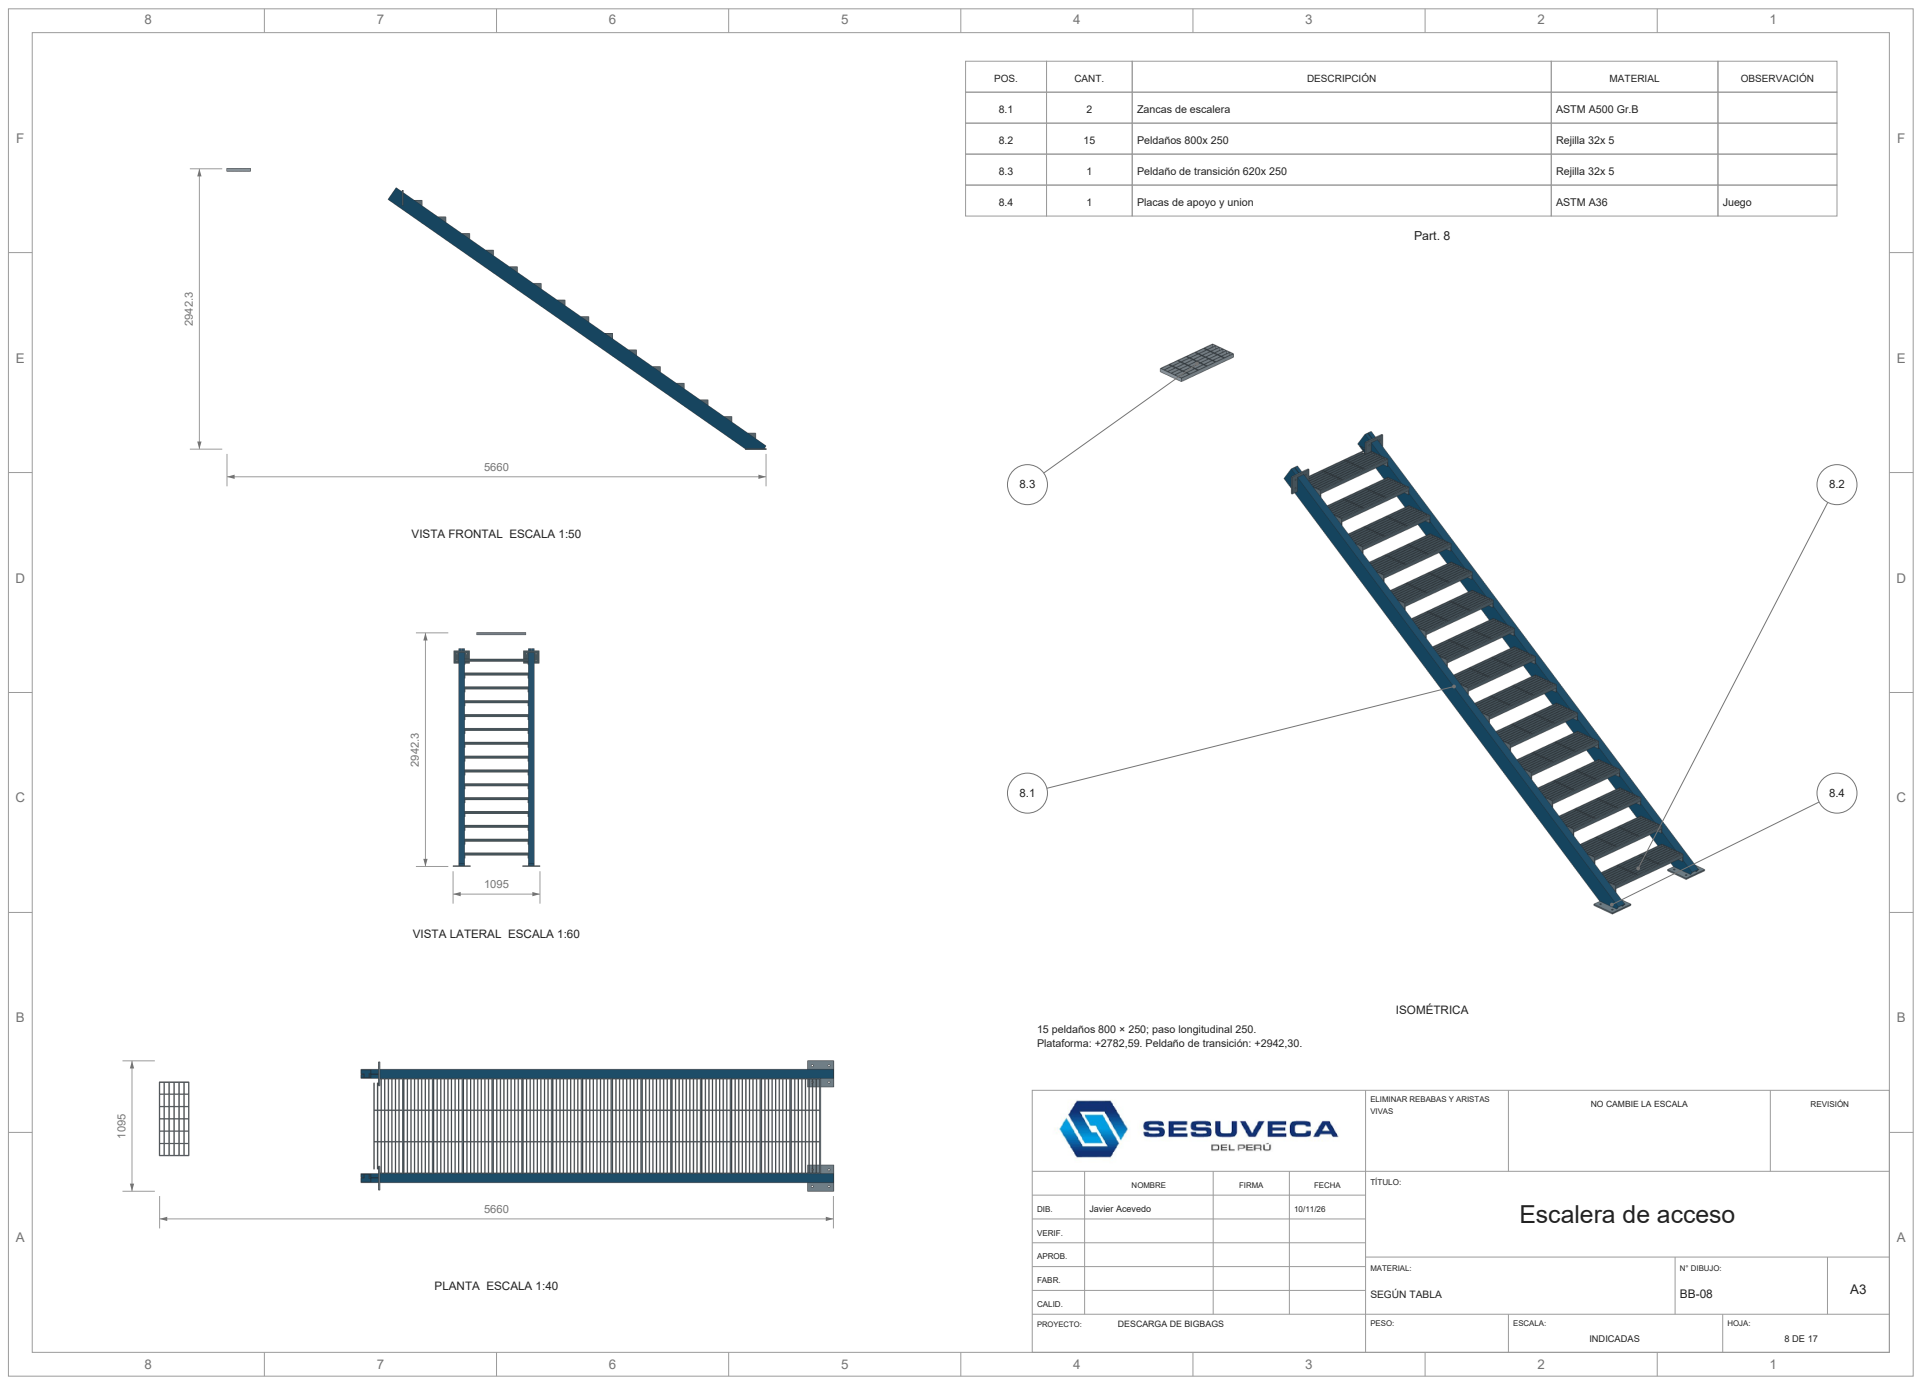
[picture p9: page 8]
NO CAMBIE LA ESCALA; REVISIÓN; NOMBRE; FIRMA; FECHA; DIB.; VERIF.; APROB.; Javier Acevedo; TÍTULO:; MATERIAL:; N° DIBUJO:; Zancas de escalera; ASTM A500 Gr.B; Peldaños 800x 250; Rejilla 32x 5; Peldaño de transición 620x 250; Placas de apoyo y union; ASTM A36; Juego; ISOMÉTRICA; Part. 8

VISTA FRONTAL ESCALA 1:50

VISTA LATERAL ESCALA 1:60

15 peldaños 800 × 250; paso longitudinal 250.
Plataforma: +2782,59. Peldaño de transición: +2942,30.

ELIMINAR REBABAS Y ARISTAS
VIVAS

Escalera de acceso

F | F

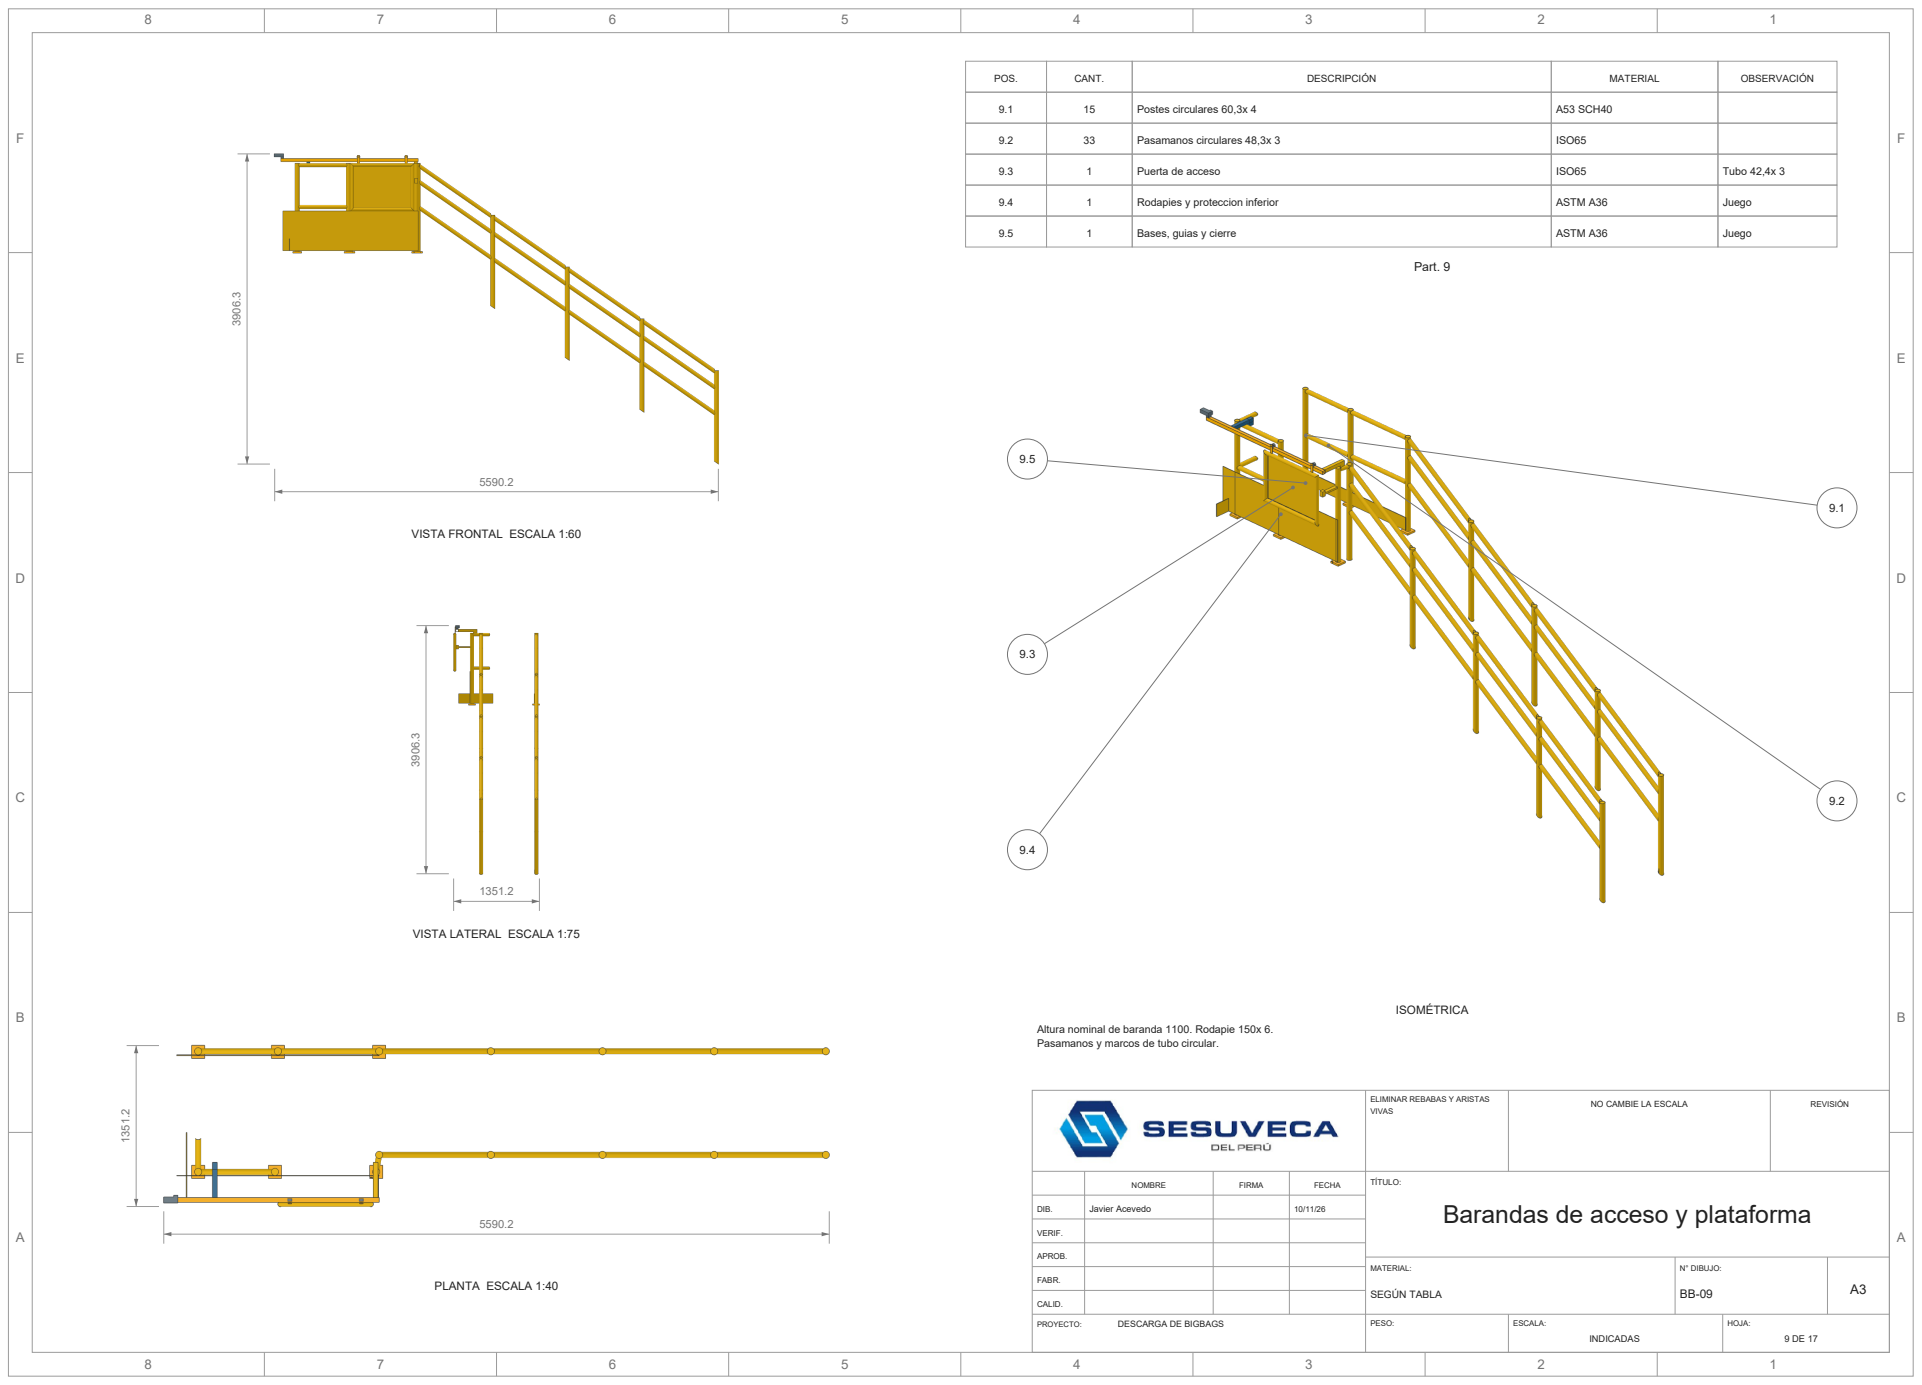
[picture p10: page 9]
NO CAMBIE LA ESCALA; REVISIÓN; NOMBRE; FIRMA; FECHA; DIB.; VERIF.; APROB.; Javier Acevedo; TÍTULO:; MATERIAL:; N° DIBUJO:; Postes circulares 60,3x 4; A53 SCH40; Pasamanos circulares 48,3x 3; ISO65; Puerta de acceso; Tubo 42,4x 3; Rodapies y proteccion inferior; ASTM A36; Juego; Bases, guias y cierre; ISOMÉTRICA; Part. 9

VISTA FRONTAL ESCALA 1:60

VISTA LATERAL ESCALA 1:75

Altura nominal de baranda 1100. Rodapie 150x 6.
Pasamanos y marcos de tubo circular.

ELIMINAR REBABAS Y ARISTAS
VIVAS

Barandas de acceso y plataforma

F | F

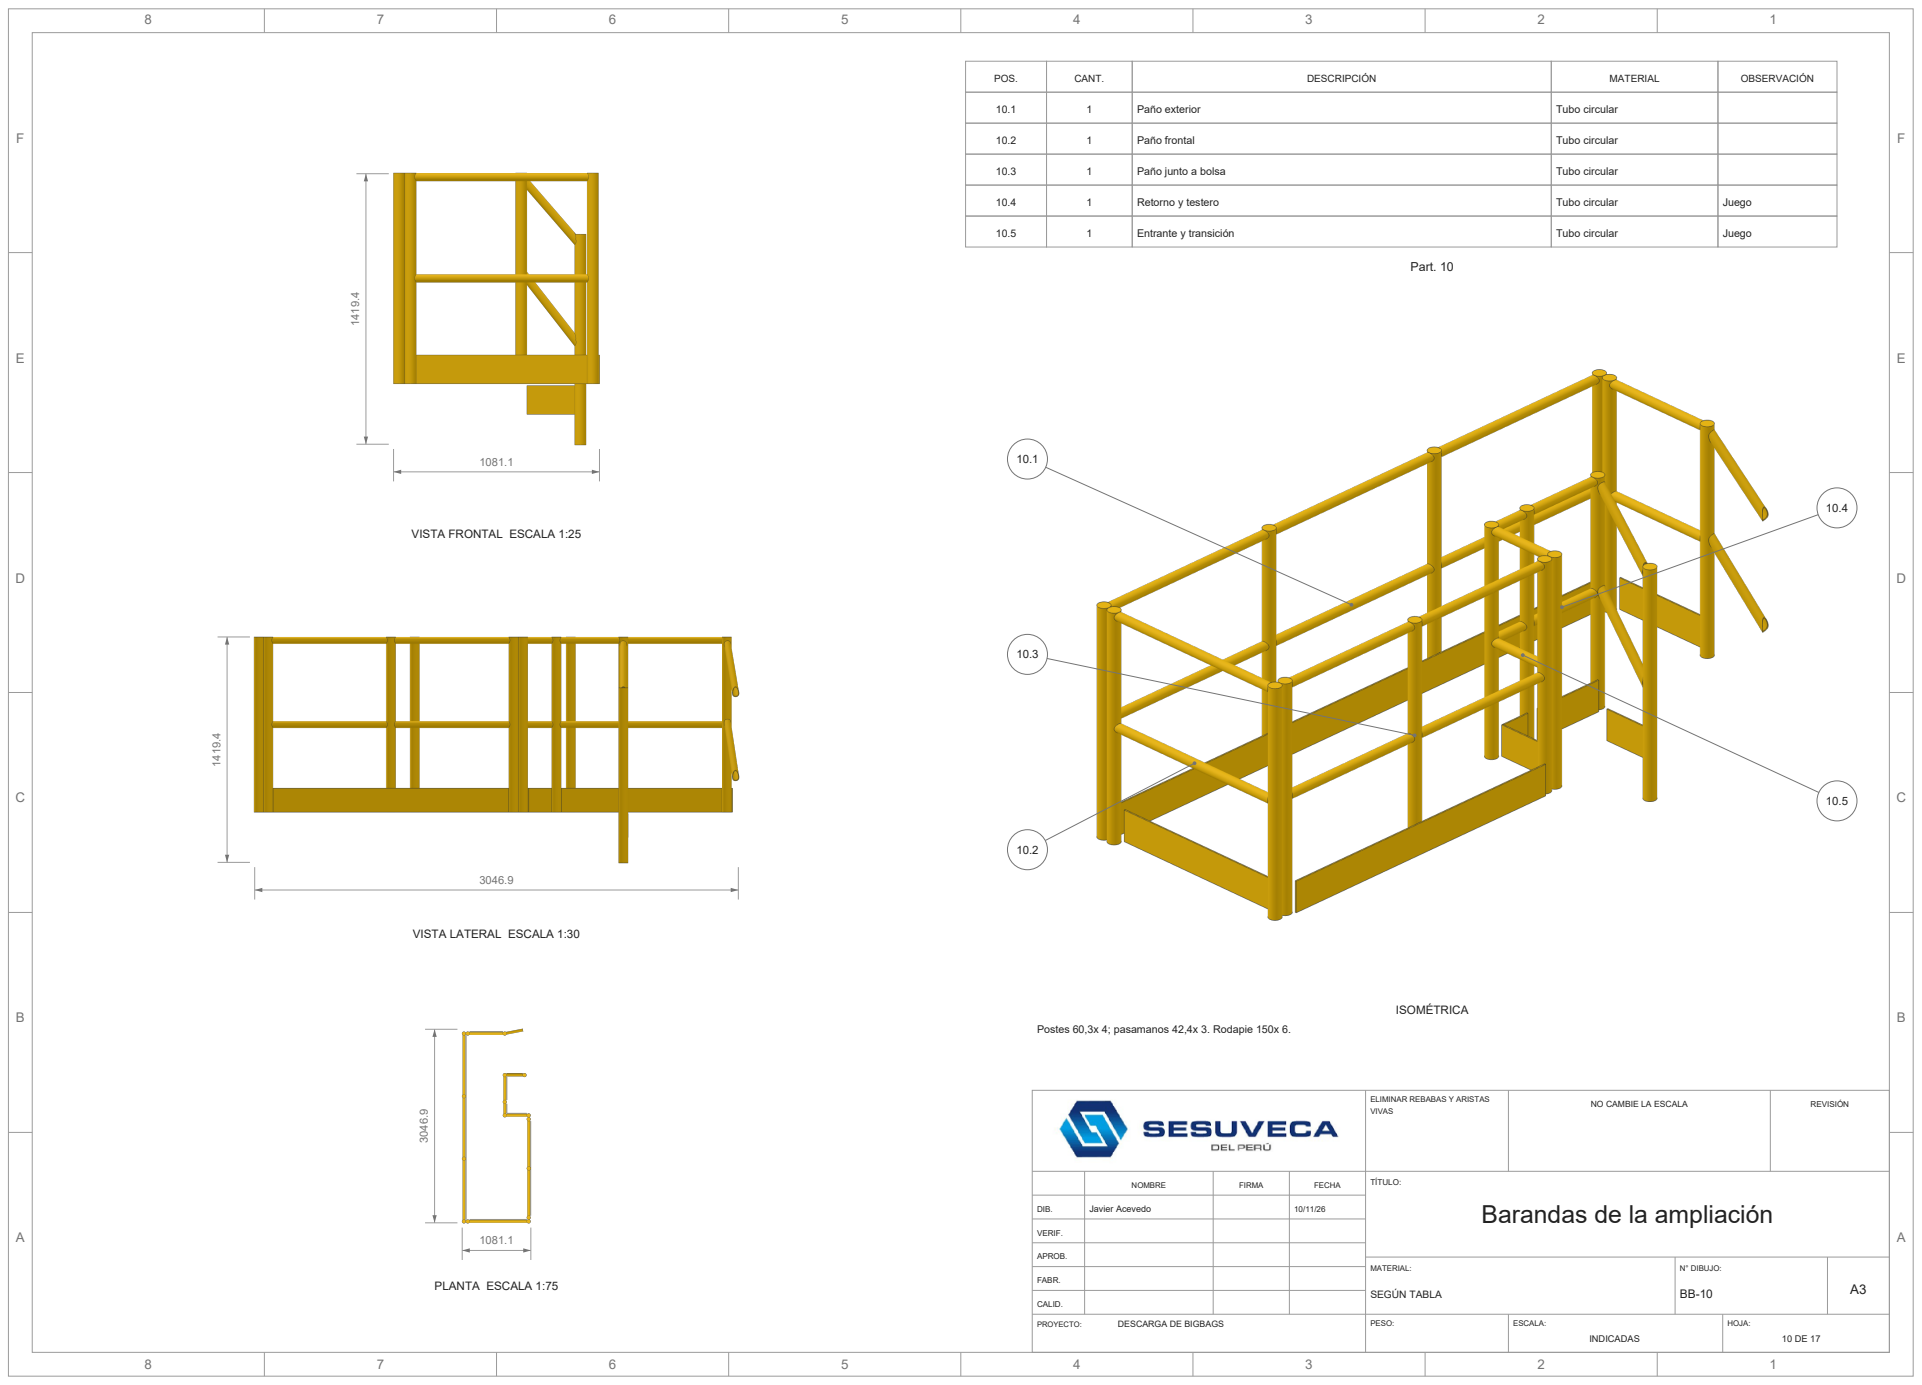
[picture p11: page 10]
NO CAMBIE LA ESCALA; REVISIÓN; NOMBRE; FIRMA; FECHA; DIB.; VERIF.; APROB.; Javier Acevedo; TÍTULO:; MATERIAL:; N° DIBUJO:; Paño exterior; Tubo circular; Paño frontal; Paño junto a bolsa; Retorno y testero; Juego; Entrante y transición; ISOMÉTRICA; Part. 10

VISTA FRONTAL ESCALA 1:25

VISTA LATERAL ESCALA 1:30

Postes 60,3x 4; pasamanos 42,4x 3. Rodapie 150x 6.

ELIMINAR REBABAS Y ARISTAS
VIVAS

Barandas de la ampliación

F | F

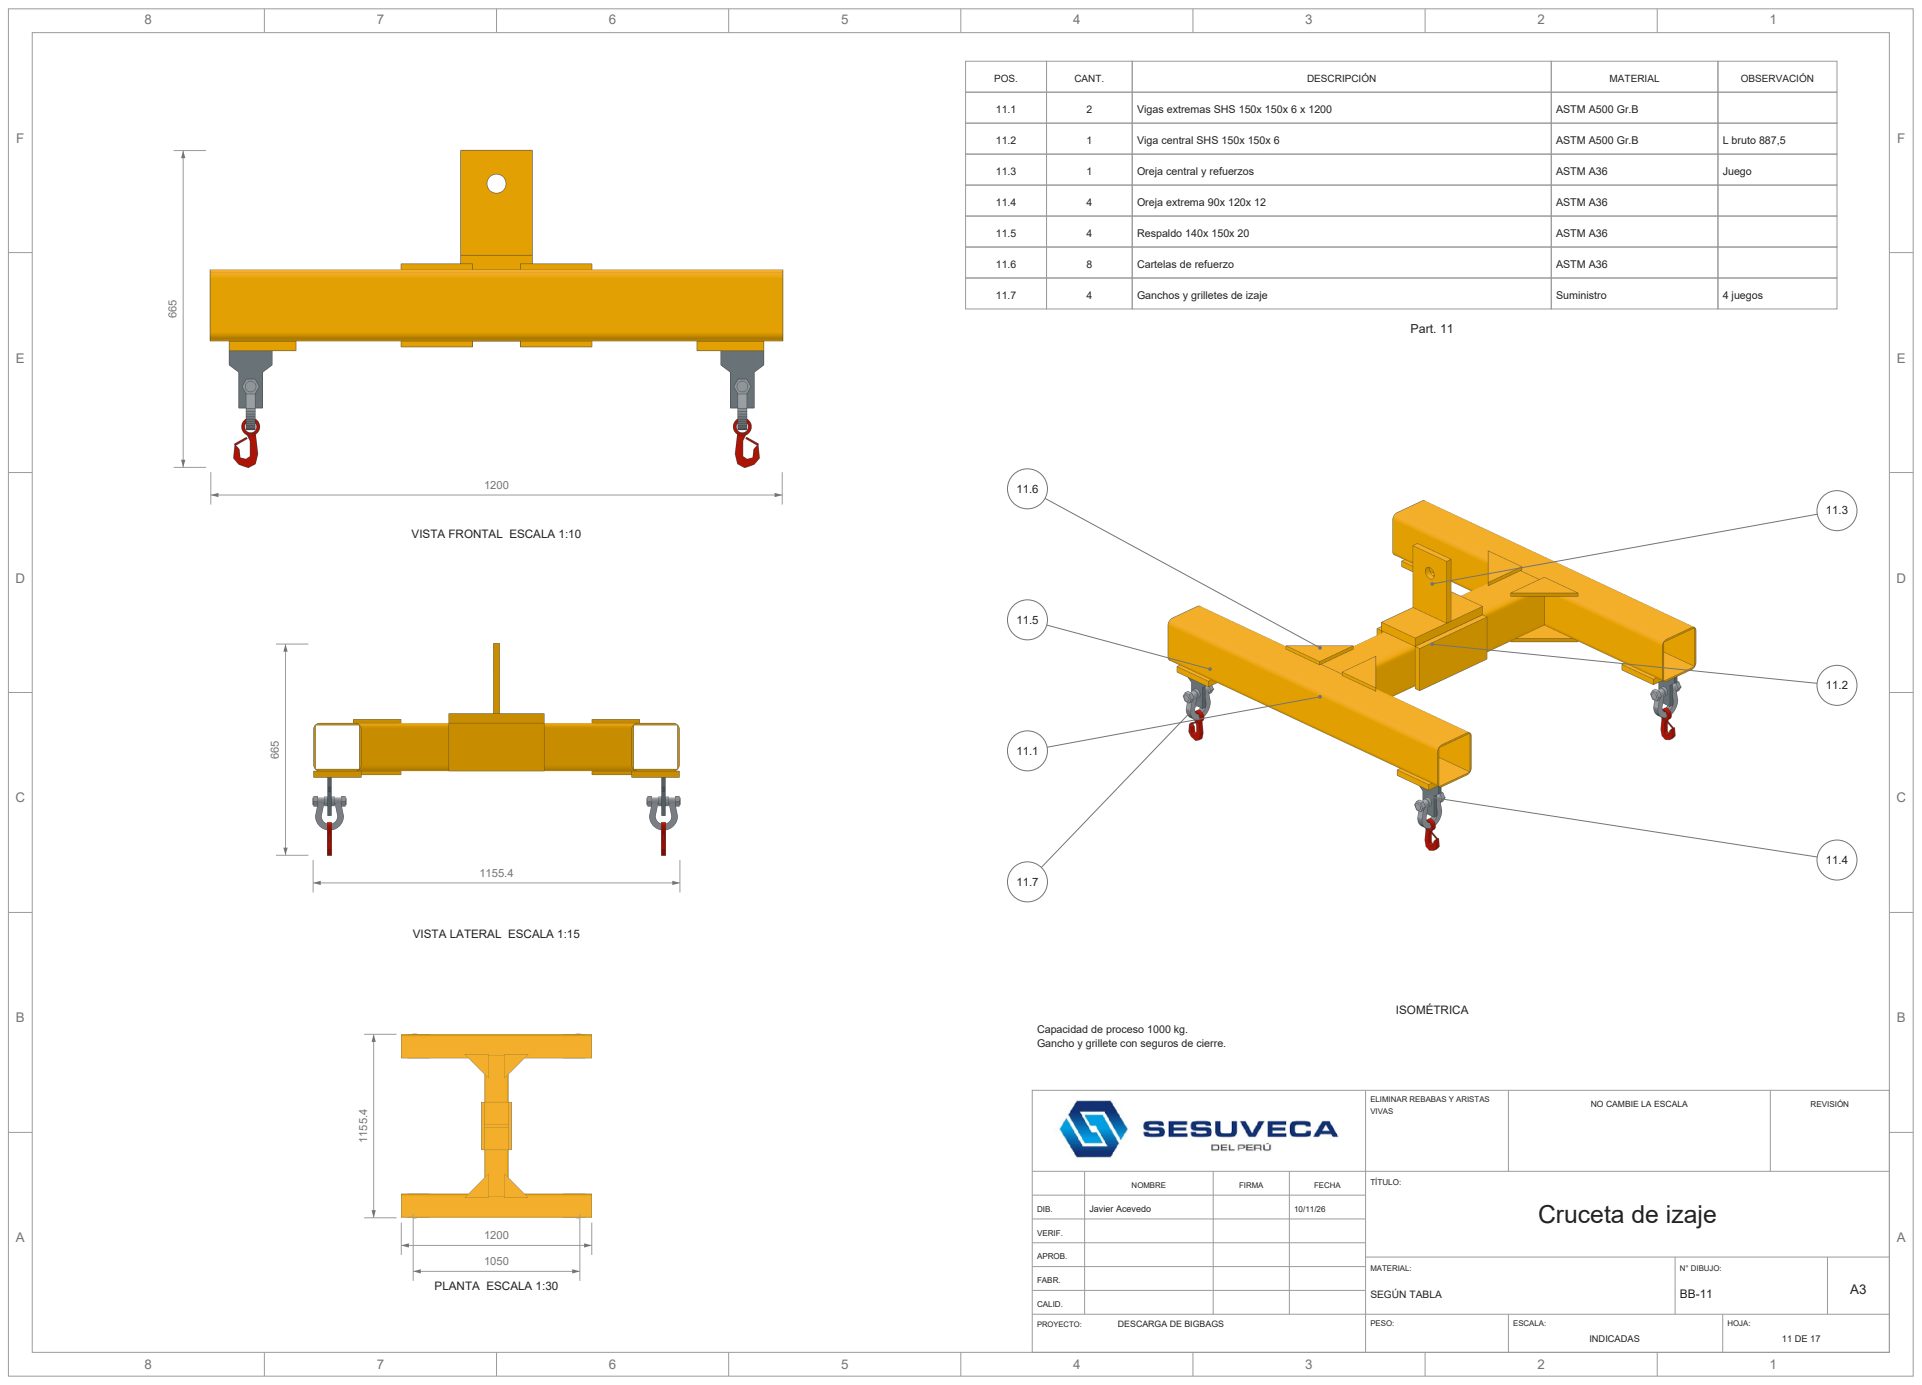
[picture p12: page 11]
NO CAMBIE LA ESCALA; REVISIÓN; NOMBRE; FIRMA; FECHA; DIB.; VERIF.; APROB.; Javier Acevedo; TÍTULO:; MATERIAL:; N° DIBUJO:; Vigas extremas SHS 150x 150x 6 x 1200; ASTM A500 Gr.B; Viga central SHS 150x 150x 6; L bruto 887,5; Oreja central y refuerzos; ASTM A36; Juego; Oreja extrema 90x 120x 12; Respaldo 140x 150x 20; Cartelas de refuerzo; Ganchos y grilletes de izaje; Suministro; 4 juegos; ISOMÉTRICA; Part. 11

VISTA FRONTAL ESCALA 1:10

VISTA LATERAL ESCALA 1:15

Capacidad de proceso 1000 kg.
Gancho y grillete con seguros de cierre.

ELIMINAR REBABAS Y ARISTAS
VIVAS

Cruceta de izaje

F | F

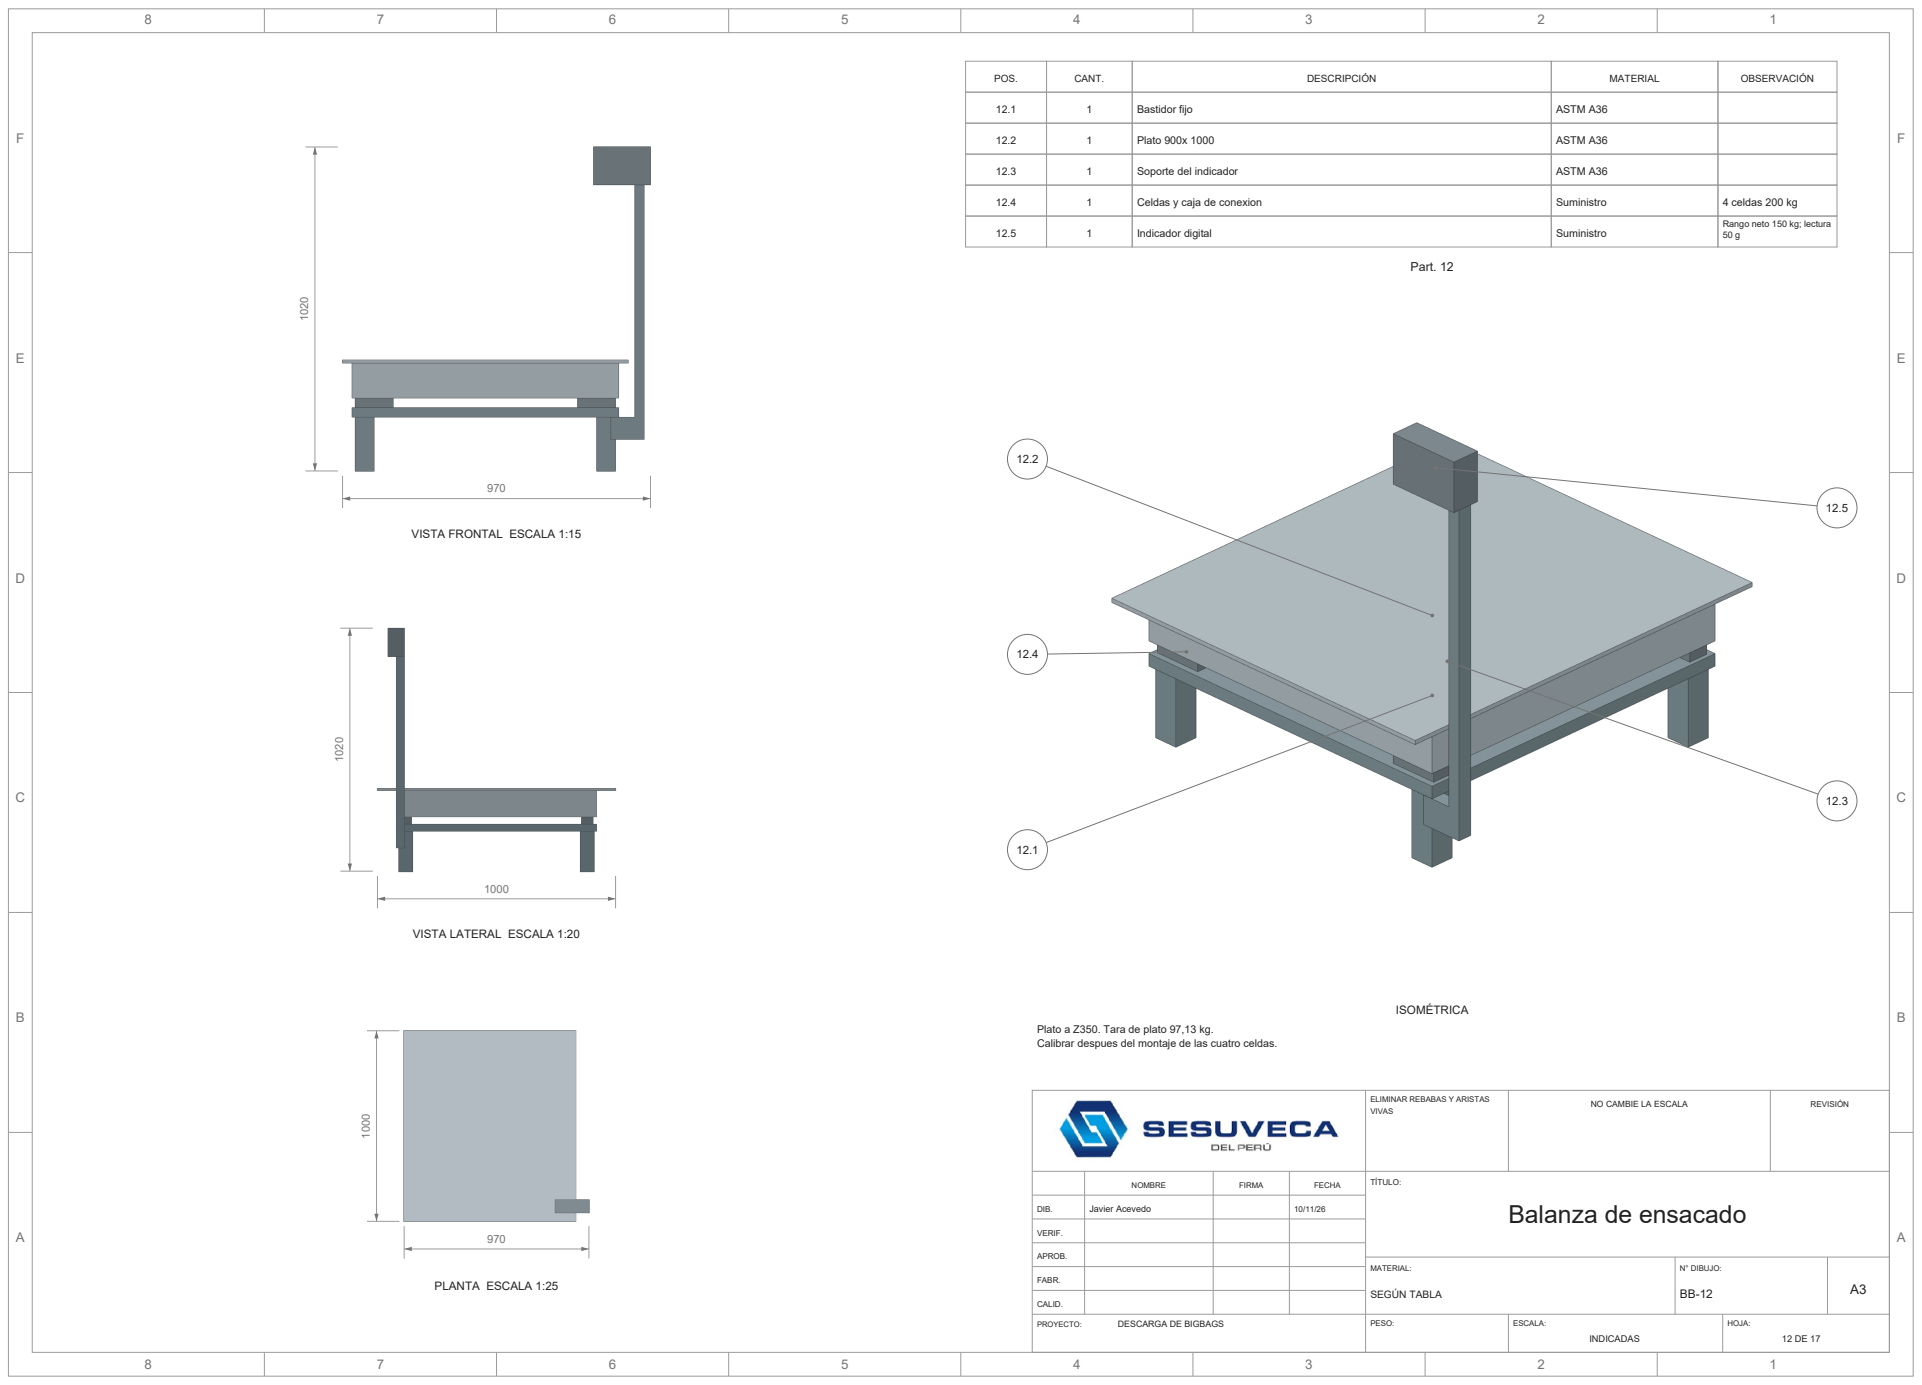
[picture p13: page 12]
NO CAMBIE LA ESCALA; REVISIÓN; NOMBRE; FIRMA; FECHA; DIB.; VERIF.; APROB.; Javier Acevedo; TÍTULO:; MATERIAL:; N° DIBUJO:; Bastidor fijo; ASTM A36; Plato 900x 1000; Soporte del indicador; Celdas y caja de conexion; Suministro; 4 celdas 200 kg; Indicador digital; ISOMÉTRICA; Part. 12

Rango neto 150 kg; lectura

VISTA FRONTAL ESCALA 1:15

VISTA LATERAL ESCALA 1:20

Plato a Z350. Tara de plato 97,13 kg.
Calibrar despues del montaje de las cuatro celdas.

ELIMINAR REBABAS Y ARISTAS
VIVAS

Balanza de ensacado

F | F

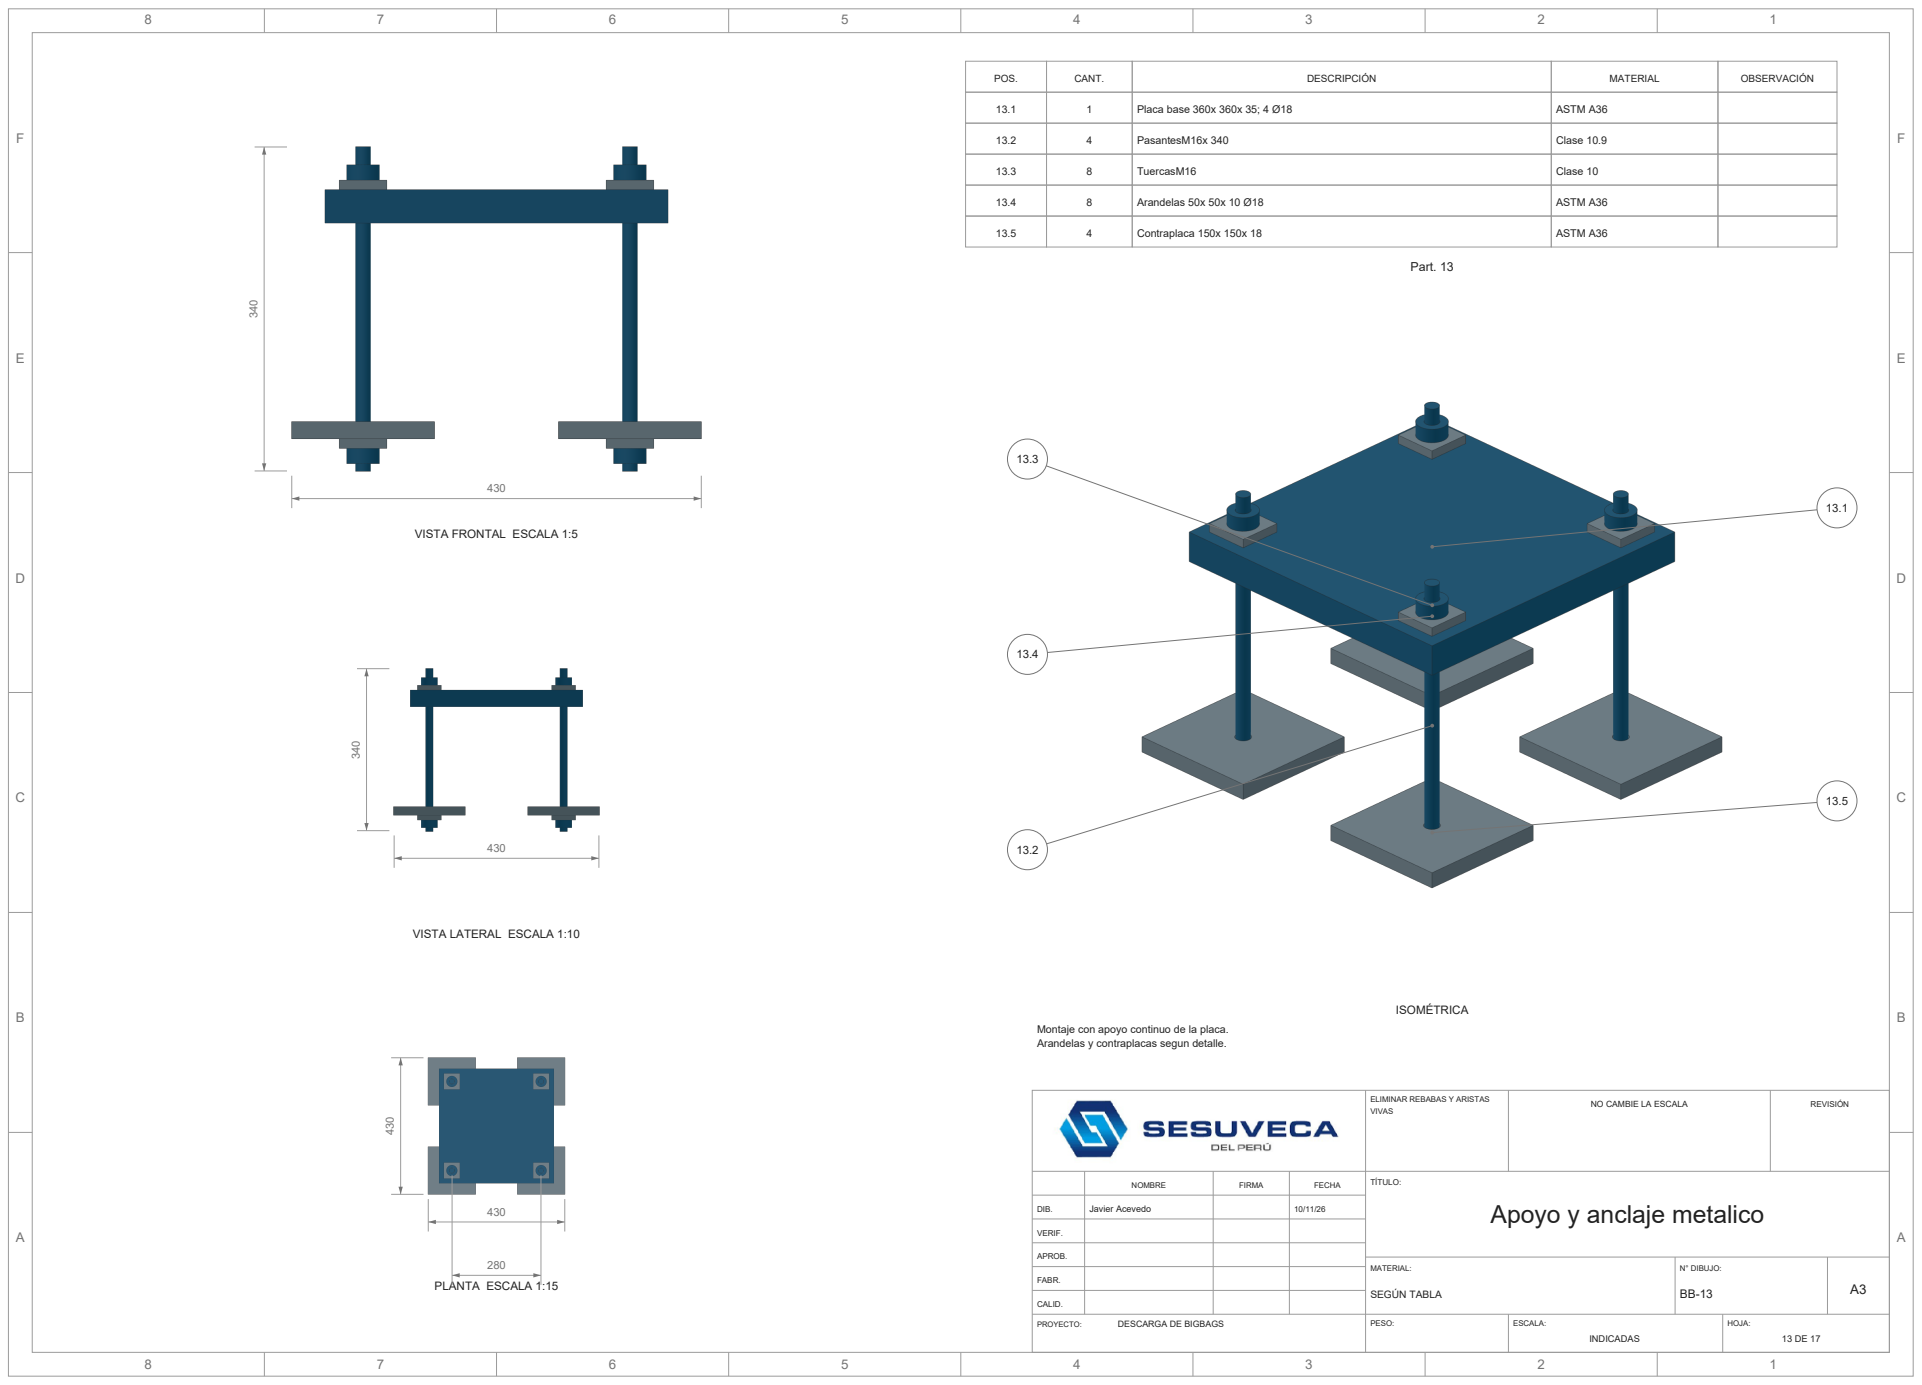
[picture p14: page 13]
NO CAMBIE LA ESCALA; REVISIÓN; NOMBRE; FIRMA; FECHA; DIB.; VERIF.; APROB.; Javier Acevedo; TÍTULO:; MATERIAL:; N° DIBUJO:; Placa base 360x 360x 35; 4 Ø18; ASTM A36; PasantesM16x 340; Clase 10.9; TuercasM16; Clase 10; Arandelas 50x 50x 10 Ø18; Contraplaca 150x 150x 18; ISOMÉTRICA; Part. 13

VISTA FRONTAL ESCALA 1:5

VISTA LATERAL ESCALA 1:10

Montaje con apoyo continuo de la placa.
Arandelas y contraplacas segun detalle.

ELIMINAR REBABAS Y ARISTAS
VIVAS

Apoyo y anclaje metalico

F | F

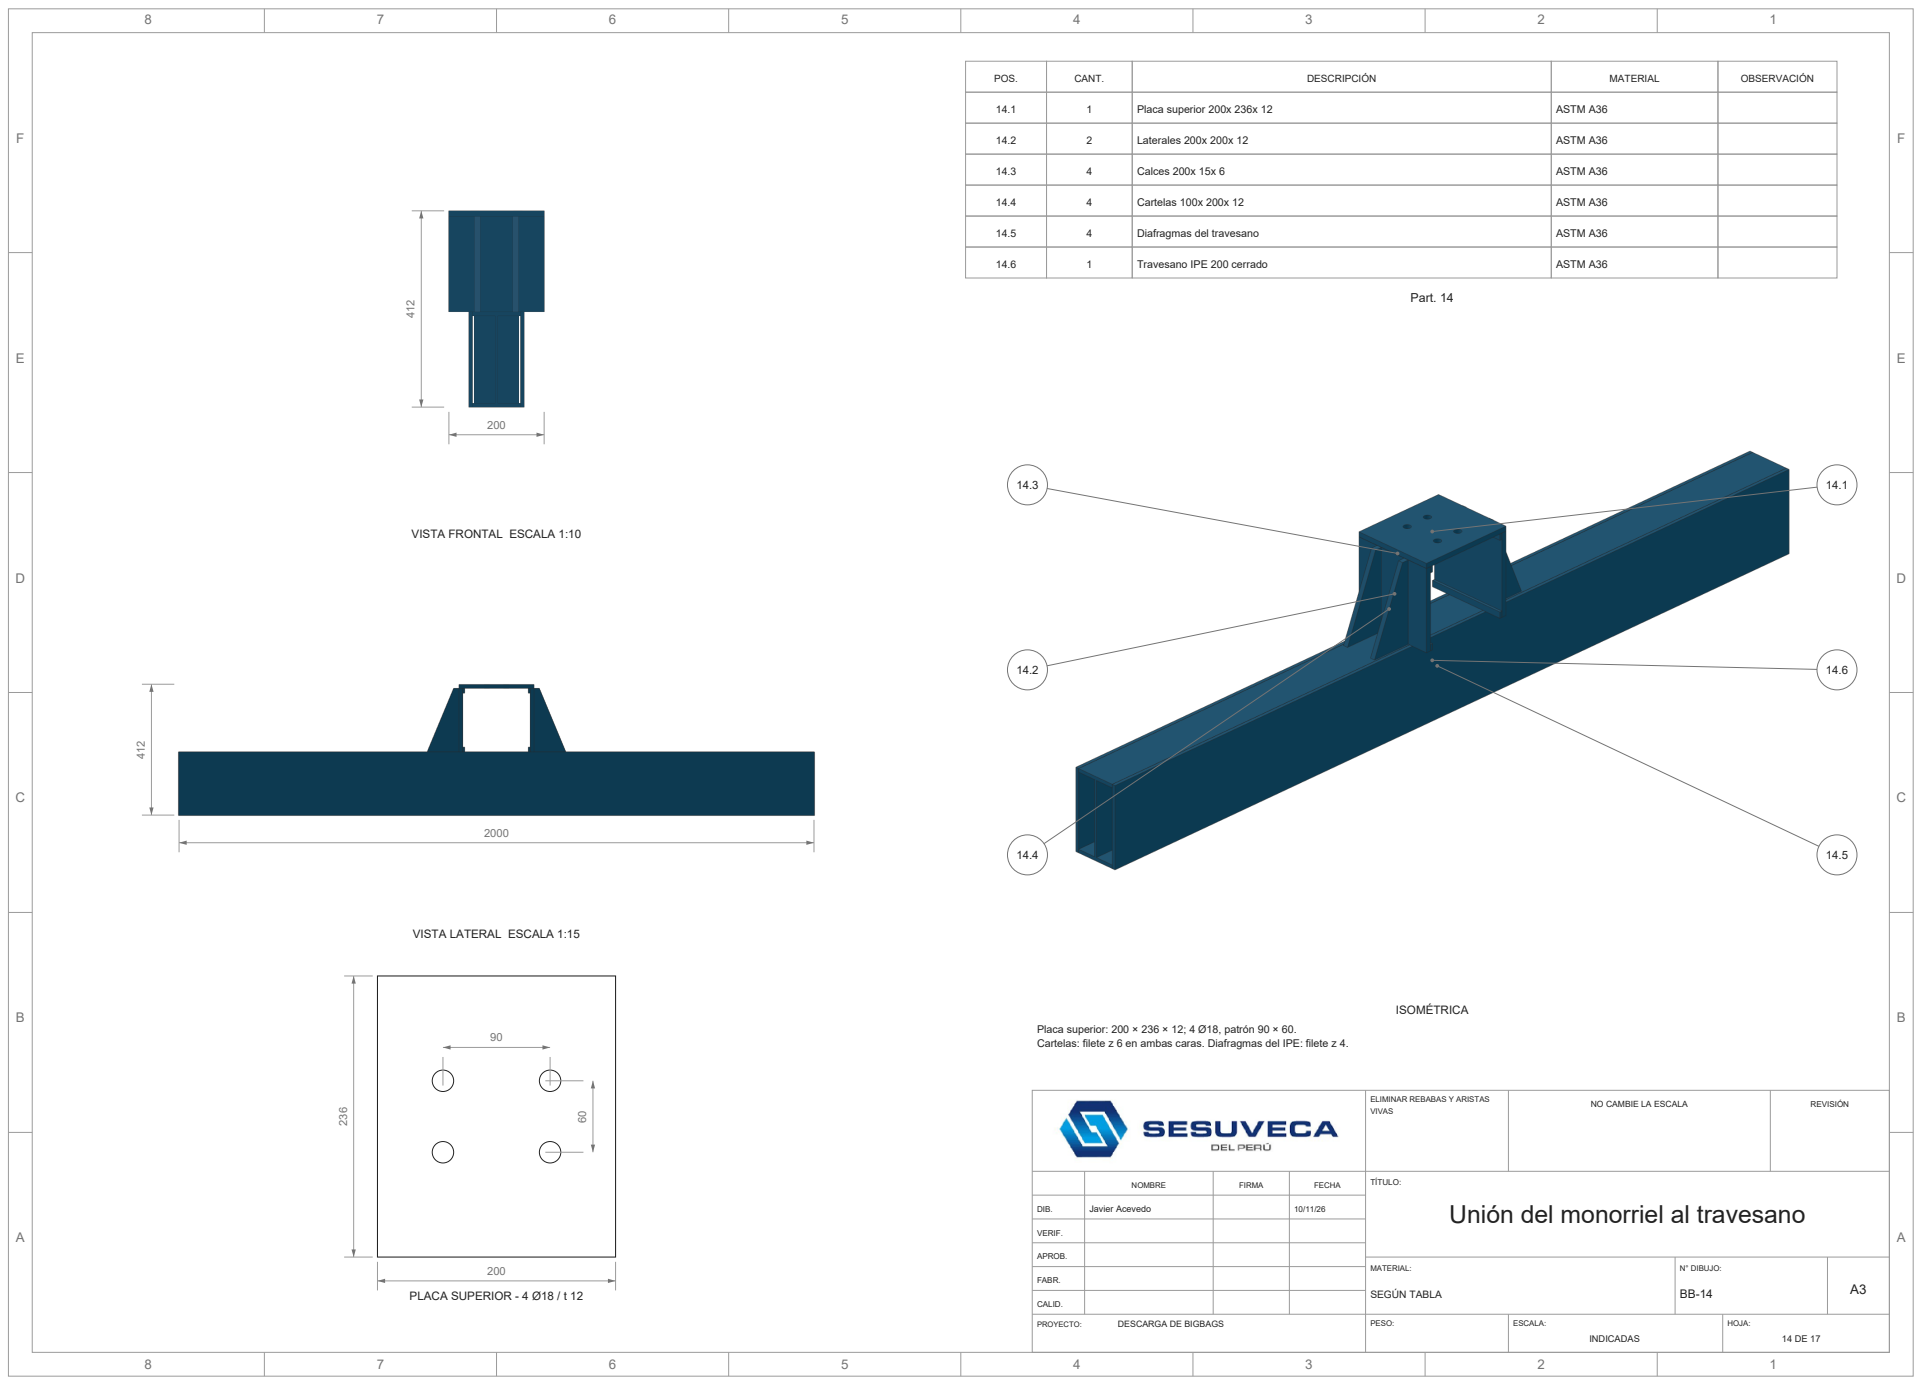
[picture p15: page 14]
NO CAMBIE LA ESCALA; REVISIÓN; NOMBRE; FIRMA; FECHA; DIB.; VERIF.; APROB.; Javier Acevedo; TÍTULO:; MATERIAL:; N° DIBUJO:; Placa superior 200x 236x 12; ASTM A36; Laterales 200x 200x 12; Calces 200x 15x 6; Cartelas 100x 200x 12; Diafragmas del travesano; Travesano IPE 200 cerrado; PLACA SUPERIOR - 4 Ø18 / t 12; ISOMÉTRICA; Part. 14

VISTA FRONTAL ESCALA 1:10

VISTA LATERAL ESCALA 1:15

Placa superior: 200 × 236 × 12; 4 Ø18, patrón 90 × 60.
Cartelas: filete z 6 en ambas caras. Diafragmas del IPE: filete z 4.

ELIMINAR REBABAS Y ARISTAS
VIVAS

Unión del monorriel al travesano

F | F

### 4 PANELES DE CUERPO

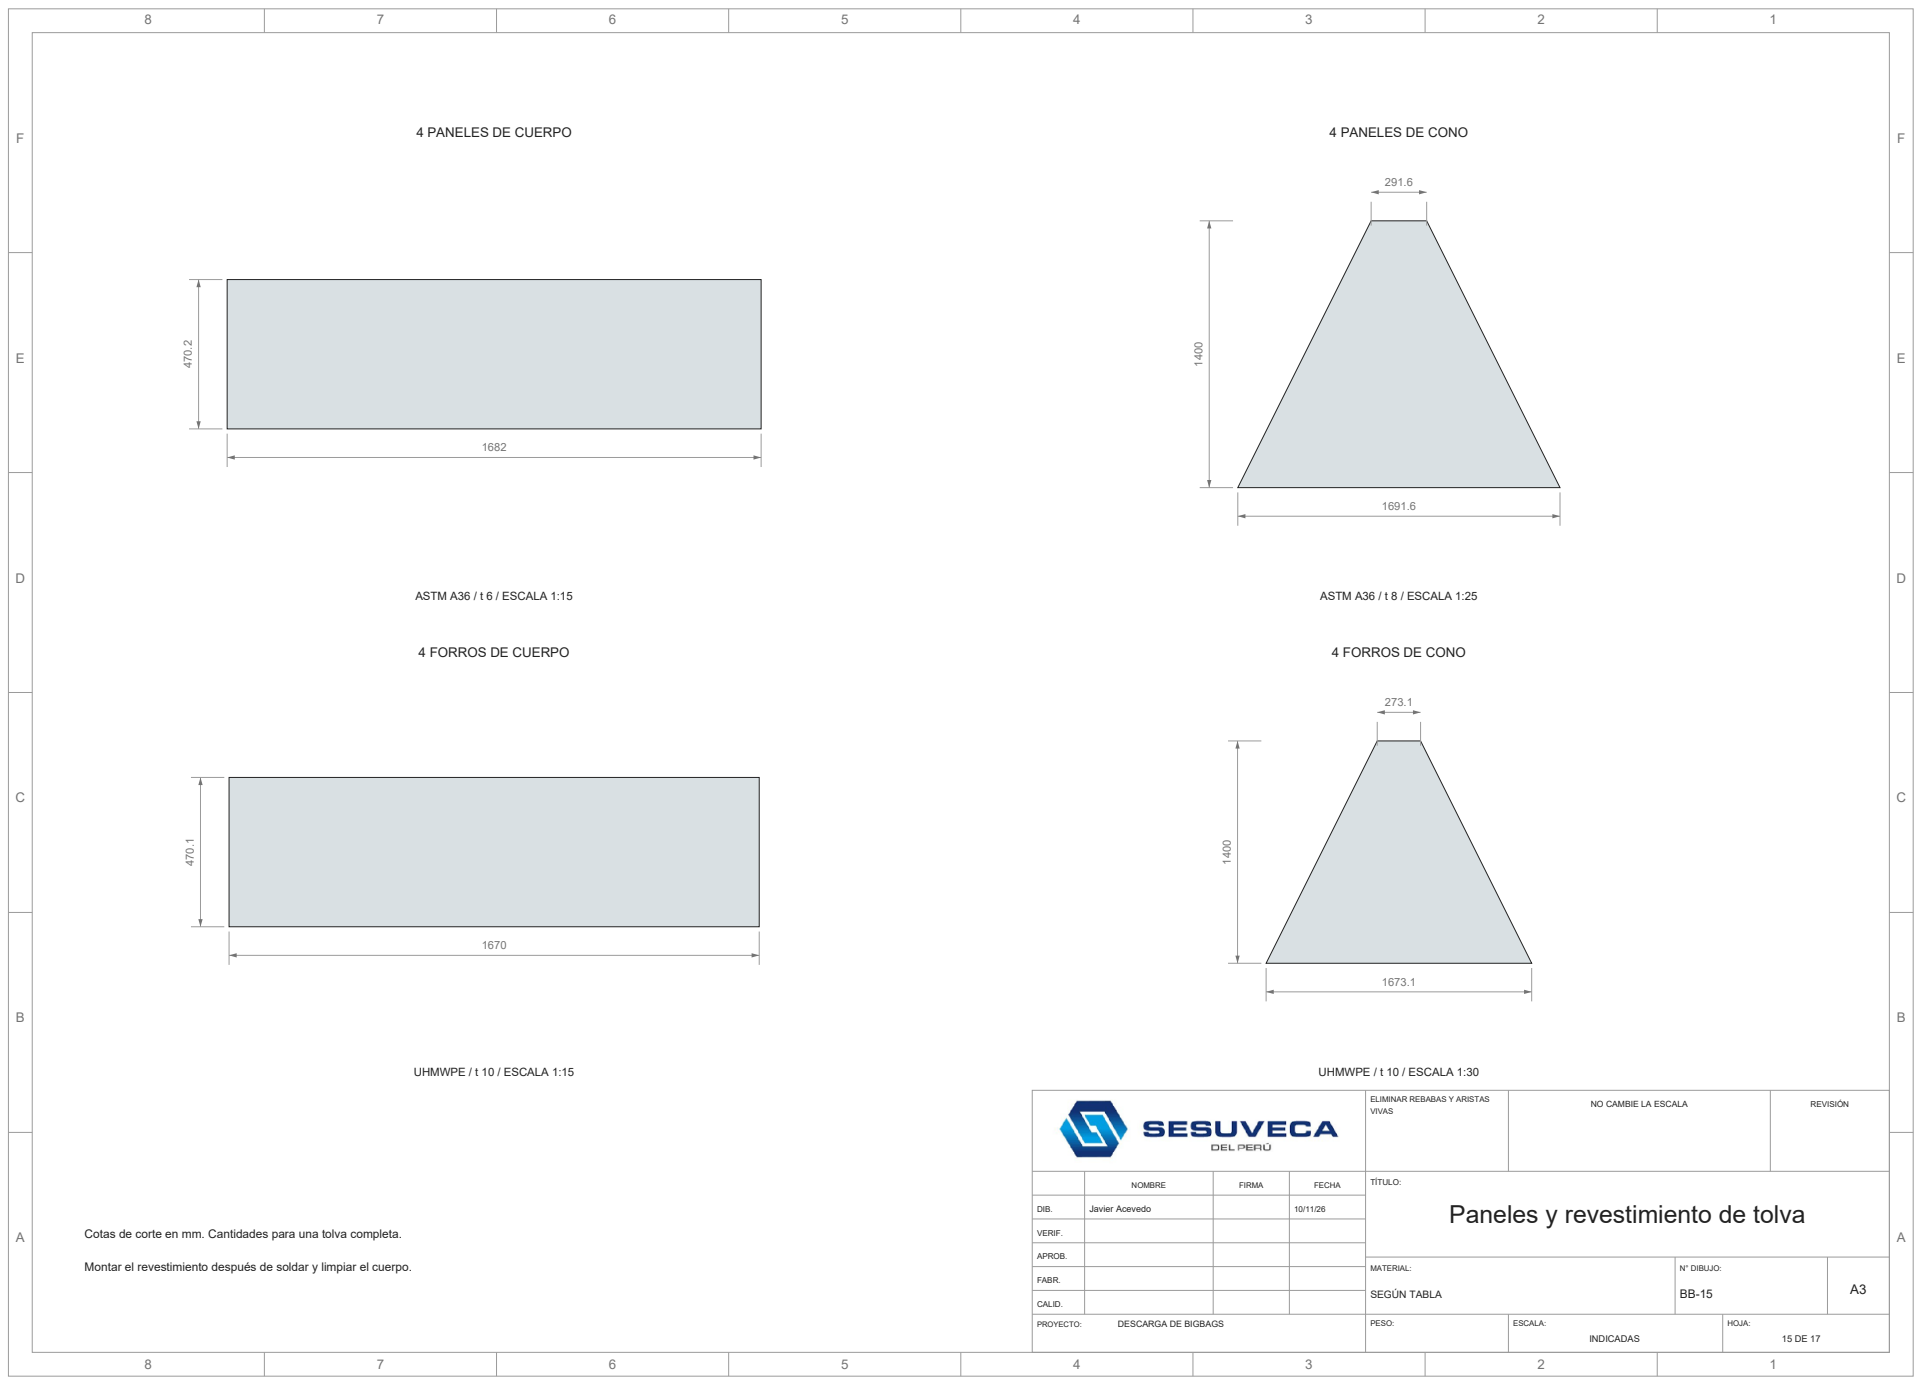
[picture p16: page 15]
NO CAMBIE LA ESCALA; REVISIÓN; NOMBRE; FIRMA; FECHA; DIB.; VERIF.; APROB.; Javier Acevedo; TÍTULO:; MATERIAL:; N° DIBUJO:; ASTM A36 / t 6 / ESCALA 1:15; ASTM A36 / t 8 / ESCALA 1:25; UHMWPE / t 10 / ESCALA 1:15; UHMWPE / t 10 / ESCALA 1:30

4 PANELES DE CONO

4 FORROS DE CUERPO

4 FORROS DE CONO

ELIMINAR REBABAS Y ARISTAS
VIVAS

Paneles y revestimiento de tolva

Cotas de corte en mm. Cantidades para una tolva completa.

Montar el revestimiento después de soldar y limpiar el cuerpo.

A | A
B | B
C | C
D | D
E | E
F | F

ELIMINAR REBABAS Y ARISTAS VIVAS

NO CAMBIE LA ESCALA | REVISIÓN
NOMBRE | FIRMA | FECHA

DIB.

VERIF.

APROB.

Javier Acevedo | | 10/11/26

TÍTULO:

# Lista de cortes de perfiles

MATERIAL:

N° DIBUJO:
BB-C1 | A3
PLANO | POS. | CANT. | PERFIL | L mm
BB-02 | 2.1 | 4 | SHS 150x 150x 6 | 6668
BB-02 | 2.2 | 2 | IPE 200 | 2000
BB-02 | 2.3 | 4 | SHS 60x 60x 4 | 6435.8
BB-02 | 2.4 | 4 | SHS 60x 60x 4 | 3038
BB-02 | 2.5 | 4 | SHS 60x 60x 4 | 1466.6
BB-03 | 3.1 | 1 | HEB 200 | 3600
BB-04 | 4.1 | 4 | SHS 100x 100x 5 | 2848
BB-04 | 4.2 | 2 | Macizo 60x 60 | 195
BB-04 | 4.2 | 1 | Macizo 60x 60 | 350
BB-04 | 4.2 | 1 | Macizo 60x 60 | 500
BB-04 | 4.2 | 1 | Macizo 60x 60 | 1100
BB-04 | 4.2 | 2 | SHS 150x 150x 6 | 1800
BB-04 | 4.2 | 2 | SHS 150x 150x 6 | 2050
BB-04 | 4.2 | 2 | SHS 60x 60x 4 | 1550
BB-04 | 4.2 | 1 | SHS 60x 60x 4 | 1950
BB-04 | 4.3 | 4 | RHS 100x 60x 6.3 | 1812
BB-04 | 4.3 | 4 | RHS 150x 75x 5 | 1832
BB-04 | 4.3 | 4 | SHS 100x 100x 5 | 1599.3
BB-04 | 4.4 | 2 | SHS 60x 60x 4 | 2976.3
BB-04 | 4.5 | 4 | SHS 60x 60x 4 | 62.4
BB-04 | 4.6 | 4 | SHS 100x 100x 5 | 1900
BB-06 | 6.1 | 1 | Redondo 40 | 40
BB-06 | 6.1 | 1 | Redondo 40 | 245
BB-06 | 6.2 | 1 | Redondo 16 | 300
BB-06 | 6.2 | 1 | Redondo 20 | 695
BB-07 | 7.1 | 1 | SHS 100x 100x 5 | 2570.6
PLANO | POS. | CANT. | PERFIL | L mm
BB-07 | 7.1 | 3 | SHS 100x 100x 5 | 2578.6
BB-07 | 7.2 | 5 | RHS 150x 75x 5 | 105
BB-07 | 7.2 | 1 | RHS 150x 75x 5 | 1620
BB-07 | 7.2 | 2 | RHS 150x 75x 5 | 1780
BB-07 | 7.2 | 5 | SHS 60x 60x 4 | 725
BB-07 | 7.3 | 2 | SHS 60x 60x 4 | 2914.3
BB-07 | 7.4 | 2 | Macizo 40x 60 | 60
BB-07 | 7.4 | 2 | RHS 60x 40x 4 | 257.4
BB-07 | 7.4 | 2 | SHS 50x 50x 4 | 67.7
BB-07 | 7.4 | 2 | SHS 60x 60x 4 | 250
BB-07 | 7.4 | 2 | SHS 60x 60x 4 | 760
BB-07 | 7.4 | 4 | SHS 60x 60x 4 | 1075
BB-07 | 7.4 | 1 | SHS 60x 60x 4 | 1300
BB-07 | 7.4 | 1 | SHS 60x 60x 4 | 1700
BB-07 | 7.4 | 1 | SHS 60x 60x 4 | 3000
BB-08 | 8.1 | 2 | RHS 150x 75x 5 | 4728.1
BB-09 | 9.1 | 6 | CHS 60.3x 4 | 1107
BB-09 | 9.1 | 1 | CHS 60.3x 4 | 1127
BB-09 | 9.1 | 8 | CHS 60.3x 4 | 1174.6
BB-09 | 9.2 | 1 | CHS 48.3x 3 | 108.6
BB-09 | 9.2 | 2 | CHS 48.3x 3 | 263.9
BB-09 | 9.2 | 2 | CHS 48.3x 3 | 608.9
BB-09 | 9.2 | 2 | CHS 48.3x 3 | 633.9
BB-09 | 9.2 | 2 | CHS 48.3x 3 | 813.9
BB-09 | 9.2 | 24 | CHS 48.3x 3 | 1105.9
BB-09 | 9.3 | 2 | CHS 42.4x 3 | 602.4

Longitudes de corte en mm. Columnas y riostras longitudinales de una sola barra.

Presentar ingletes y encuentros antes de soldar. Corte recto: ±2 mm.

A | A
B | B
C | C
D | D
E | E
F | F

ELIMINAR REBABAS Y ARISTAS VIVAS

NO CAMBIE LA ESCALA | REVISIÓN
NOMBRE | FIRMA | FECHA

DIB.

VERIF.

APROB.

Javier Acevedo | | 10/11/26

TÍTULO:

# Lista de cortes de perfiles

MATERIAL:

N° DIBUJO:
BB-C2 | A3
PLANO | POS. | CANT. | PERFIL | L mm
BB-09 | 9.3 | 1 | CHS 42.4x 3 | 802.7
BB-09 | 9.3 | 1 | CHS 42.4x 3 | 802.9
BB-09 | 9.5 | 1 | SHS 40x 40x 3 | 1725
BB-10 | 10.1 | 6 | CHS 42.4x 3 | 937.1
BB-10 | 10.1 | 4 | CHS 60.3x 4 | 1097
BB-10 | 10.2 | 2 | CHS 42.4x 3 | 912.1
BB-10 | 10.2 | 2 | CHS 60.3x 4 | 1097
BB-10 | 10.3 | 4 | CHS 42.4x 3 | 727.1
BB-10 | 10.3 | 3 | CHS 60.3x 4 | 1097
BB-10 | 10.4 | 2 | CHS 42.4x 3 | 377.1
BB-10 | 10.4 | 2 | CHS 42.4x 3 | 537.1
BB-10 | 10.4 | 4 | CHS 60.3x 4 | 1097
BB-10 | 10.5 | 2 | CHS 42.4x 3 | 167.1
BB-10 | 10.5 | 2 | CHS 42.4x 3 | 332.1
BB-10 | 10.5 | 1 | CHS 42.4x 3 | 429.3
BB-10 | 10.5 | 1 | CHS 42.4x 3 | 433.2
BB-10 | 10.5 | 1 | CHS 42.4x 3 | 459.3
BB-10 | 10.5 | 1 | CHS 42.4x 3 | 463
BB-10 | 10.5 | 3 | CHS 60.3x 4 | 1097
BB-11 | 11.1 | 2 | SHS 150x 150x 6 | 1200
BB-11 | 11.2 | 1 | SHS 150x 150x 6 | 887.5

Longitudes de corte en mm. Columnas y riostras longitudinales de una sola barra.

Presentar ingletes y encuentros antes de soldar. Corte recto: ±2 mm.
