acevedocrisologopablo48-lgtm/simulacion-bigbag-sesuveca/(commit log)

2026-10-15 Publicar simulación interactiva de bigbags SESUVECA P05
2026-10-16 Sincronizar P05 con ensamble y planos nativos SolidWorks verificados
    [ESTACION_BIGBAG_P05.step]
2026-10-16 Actualizar P05 desde SolidWorks con despiece, BOM y calculos de detalle
    [ESTACION_BIGBAG_P05.step]
2026-10-16 Consolidar planos P05 por conjuntos e integrar verificaciones de fijacion y topes
2026-10-16 Simplificar textos tecnicos de planos, memoria y web P05
2026-10-16 Limpiar rotulos y textos de planos, memoria y web
    [ESTACION_BIGBAG.step]
2026-10-16 Mejorar realismo de equipos, materiales y operacion
2026-10-17 Simplifica refuerzos de tolva y actualiza planos y modelo
    [ESTACION_BIGBAG.step, ESTACION_BIGBAG_P05.step]
2026-10-17 Completa identificación y materiales de planos; añade desplazar cámara
2026-10-17 Unifica materiales de conjuntos con la lista de fabricación
2026-10-17 Amplía capacidad de tolva y adopta perfiles comerciales
    [ESTACION_BIGBAG.step, ESTACION_BIGBAG_P05.step]
2026-10-17 Unifica tubos y espesores de compra de la estacion
    [ESTACION_BIGBAG.step, ESTACION_BIGBAG_P05.step]
2026-10-17 Corrige objetos flotantes y apoyos de la simulacion
2026-10-19 Añade colector compacto y conexion de extraccion
2026-10-19 Redistribuir carga y ensacado, elevar acceso y captar polvo desde tapa
    [ESTACION_BIGBAG.step, ESTACION_BIGBAG_P05.step]
2026-10-19 Corregir tildes y simbolos en datos de la estacion
2026-10-20 Actualiza P05 y agrega despiece vigente de 175 piezas
    [ESTACION_BIGBAG.step, ESTACION_BIGBAG_P05.step]
2026-10-20 Ordena planos por conjuntos y simplifica la presentacion del proyecto
2026-10-20 Actualizar planos de conjuntos, enganches y peldaños de rejilla
    [ESTACION_BIGBAG.step, ESTACION_BIGBAG_P05.step]
2026-10-21 Actualizar altura de izaje, cortador y entrega SolidWorks
    [ESTACION_BIGBAG.step]
2026-10-21 Sincronizar alias STEP de la entrega
    [ESTACION_BIGBAG_P05.step]
2026-10-21 Actualizar dosificacion automatica, pesaje y planos P05
    [ESTACION_BIGBAG.step, ESTACION_BIGBAG_P05.step]
2026-10-21 Uniformar pórticos y consolidar pesaje y soportes
    [ESTACION_BIGBAG.step, ESTACION_BIGBAG_P05.step]
2026-10-22 Corregir uniones y emitir planos A3
    [ESTACION_BIGBAG.step, ESTACION_BIGBAG_P05.step]
2026-10-22 Corrige cotas de taller A3 y contraste de vistas SolidWorks
2026-10-23 Actualiza legajo A3 con despieces, cotas y soldaduras de taller
    [ESTACION_BIGBAG.step, ESTACION_BIGBAG_P05.step]
2026-11-03 Actualizar visor P05 con cierre de conexiones y modelo3D8918d9c5
2026-11-03 Simplificar P05 a descarga de manga y ensacado manual; retirar transportadores y neumática
2026-11-03 Cerrar correcciones de P05simple: conexiones, izaje, pesaje y retorno manual
2026-11-03 Simplificar fabricación P05 y completar conexión de descarga y mandos fijos
2026-11-05 Emitir planos y lista de materiales de la plataforma P05
    [Lista_materiales_P05_20261105.xlsx]
2026-11-10 Actualizar planos de conjuntos, materiales y presentacion de la estacion
    [ESTACION_BIGBAG.step, ESTACION_BIGBAG_P05.step, Lista_materiales.xlsx, Lista_materiales_P05_20261105.xlsx]
2026-11-10 Mejorar fidelidad visual del visor CAD y detalle de curvas
